cmu-argus-1/Avionics-JetsonCarrier/USB3-2.kicad_sch

## KiCad design USB3-2.kicad_sch (2024-07-25)

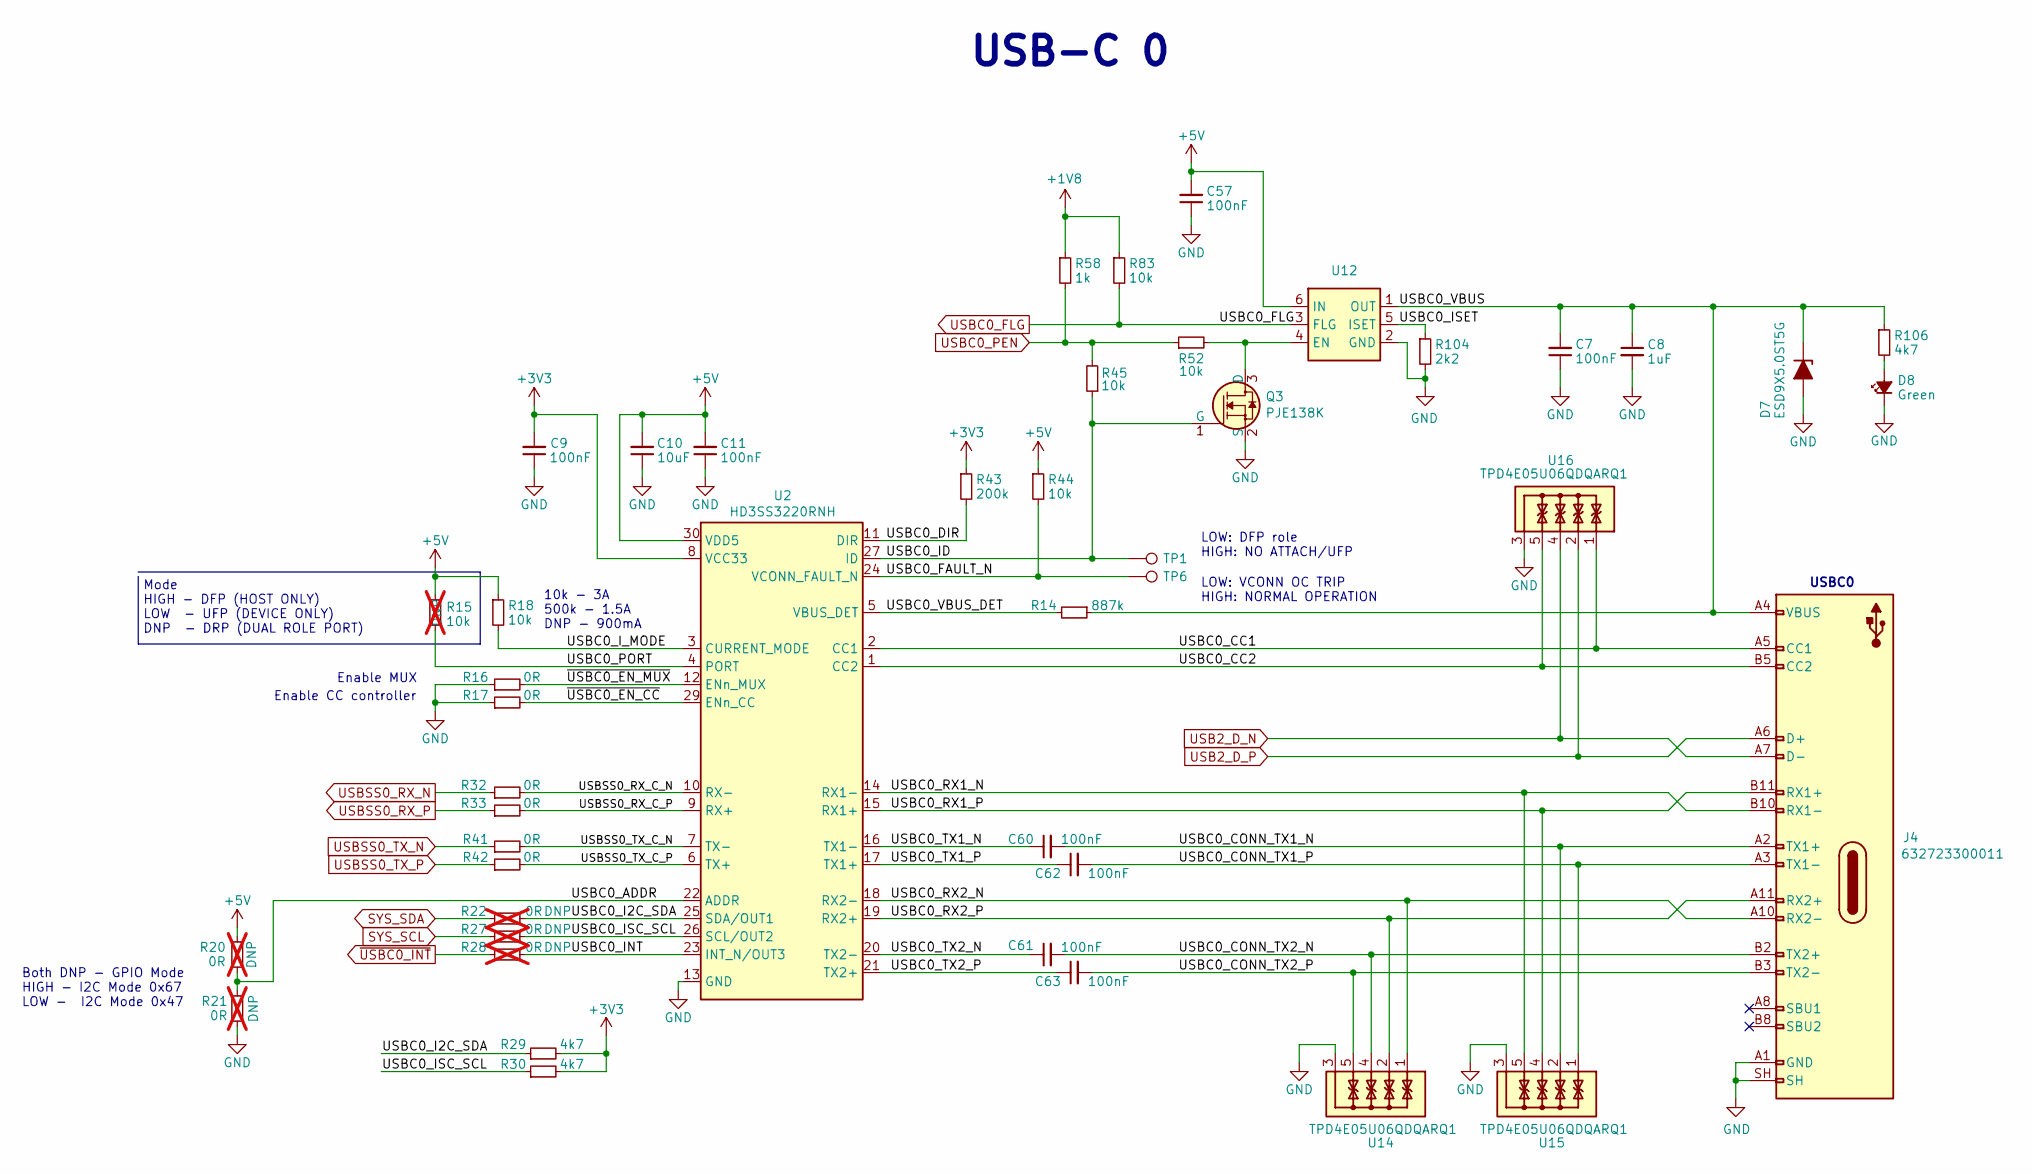
[picture p1: schematic USB3-2.kicad_sch]

Parts:
C7, C57: 100nF; C_0603_1608Metric; Voltage 50V; MPN GRM155R61H104KE14D
C8: 1uF; C_0603_1608Metric; MPN C0402C105M4PACTU
C9, C11, C60, C61, C62, C63: 100nF; C_0402_1005Metric; Voltage 50V; MPN GRM155R61H104KE14D
C10: 10uF; C_0402_1005Metric; MPN GRM188R61A106KE69D
D7: ESD9X5.0ST5G; D_SOD-923; MPN DF2S30FS
D8: LED_G_0603_LTST-C190GKT; LED_0603_1608Metric; MPN LTST-C190GKT
J4: 632723300011; USB-C_Receptacle_WE_632723300011; MPN 632723300011
Q3: PJE138K; SOT-523; MPN PJE138K_R1_00001
R14: 887k; R_0402_1005Metric; Tolerance 1%; MPN ERJ-2RKF8873X
R15: 10k; R_0402_1005Metric; Tolerance 1%; MPN CR0402-FX-1002GLF; not fitted
R16, R17, R32, R33, R41, R42: 0R; R_0402_1005Metric; MPN ERJ2GE0R00X
R18, R44, R45, R52, R83: 10k; R_0402_1005Metric; Tolerance 1%; MPN CR0402-FX-1002GLF
R20, R21, R22, R27, R28: 0R; R_0402_1005Metric; MPN ERJ2GE0R00X; not fitted
R29, R30: 4k7; R_0402_1005Metric; Tolerance 1%; MPN CR0402-FX-2003GLF
R43: 200k; R_0402_1005Metric; Tolerance 1%; MPN CR0402-FX-2003GLF
R58: 1k; R_0402_1005Metric; Tolerance 1%; MPN CR0402-FX-1002GLF
R104: 2k2; R_0402_1005Metric; Tolerance 1%; MPN CR0402-FX-2201GLF
R106: 4k7; R_0402_1005Metric; Tolerance 1%; MPN CR0402-FX-4701GLF
TP1, TP6: TP_0.75mm_SMD; TP_SMD_0.75mm
U2: HD3SS3220RNH; WQFN-30-1EP_4.6x2.6mm_P0.4mm; MPN HD3SS3220RNHT
U12: AP22615A_TSOT26; TSOT-23-6; MPN AP22615AWU-7
U14, U15, U16: TPD4E05U06QDQARQ1; USON-10_2.5x1mm_P0.5mm; MPN TPD4E05U06QDQARQ1

Connections:
+1V8: R58.1, R83.1
+3V3: C9.2, R29.2, R30.2, R43.1, U2.8 (VCC33)
+5V: C10.2, C11.2, C57.2, R15.2, R18.1, R20.2, R44.1, U2.30 (VDD5), U12.6 (IN)
GND: C7.1, C8.2, C9.1, C10.1, C11.1, C57.1, D7.2 (A), D8.1 (K), J4.A1 (GND), J4.A12 (GND), J4.B1 (GND), J4.B12 (GND), J4.SH, Q3.2 (S), R16.1, R17.1, R21.1, R104.2, U2.13 (GND), U2.28 (GND), U2.31 (GND), U12.2 (GND), U14.3, U14.8, U15.3, U15.8, U16.3, U16.8
unnamed: D8.2 (A), R106.2
unnamed: Q3.3 (D), R52.2, U12.4 (EN)
SYS_SCL: R27.1
SYS_SDA: R22.1
USB2_D_N: J4.A7 (D-), J4.B7 (D-), U16.4, U16.7
USB2_D_P: J4.A6 (D+), J4.B6 (D+), U16.2, U16.9
USBC0_ADDR: R20.1, R21.2, U2.22 (ADDR)
USBC0_CC1: J4.A5 (CC1), U2.2 (CC1), U16.1, U16.10
USBC0_CC2: J4.B5 (CC2), U2.1 (CC2), U16.5, U16.6
USBC0_CONN_TX1_N: C60.2, J4.A2 (TX1+), U15.2, U15.9
USBC0_CONN_TX1_P: C62.2, J4.A3 (TX1-), U15.1, U15.10
USBC0_CONN_TX2_N: C61.2, J4.B2 (TX2+), U14.4, U14.7
USBC0_CONN_TX2_P: C63.2, J4.B3 (TX2-), U14.5, U14.6
USBC0_DIR: R43.2, U2.11 (DIR)
USBC0_FAULT_N: R44.2, TP6.1, U2.24 (VCONN_FAULT_N)
USBC0_FLG: R83.2, U12.3 (FLG)
USBC0_I2C_SDA: R22.2, R29.1, U2.25 (SDA/OUT1)
USBC0_ID: Q3.1 (G), R45.1, TP1.1, U2.27 (ID)
USBC0_INT: R28.2, U2.23 (INT_N/OUT3)
USBC0_ISC_SCL: R27.2, R30.1, U2.26 (SCL/OUT2)
USBC0_ISET: R104.1, U12.5 (ISET)
USBC0_I_MODE: R18.2, U2.3 (CURRENT_MODE)
USBC0_PEN: R45.2, R52.1, R58.2
USBC0_PORT: R15.1, U2.4 (PORT)
USBC0_RX1_N: J4.B10 (RX1-), U2.14 (RX1-), U15.5, U15.6
USBC0_RX1_P: J4.B11 (RX1+), U2.15 (RX1+), U15.4, U15.7
USBC0_RX2_N: J4.A10 (RX2-), U2.18 (RX2-), U14.1, U14.10
USBC0_RX2_P: J4.A11 (RX2+), U2.19 (RX2+), U14.2, U14.9
USBC0_TX1_N: C60.1, U2.16 (TX1-)
USBC0_TX1_P: C62.1, U2.17 (TX1+)
USBC0_TX2_N: C61.1, U2.20 (TX2-)
USBC0_TX2_P: C63.1, U2.21 (TX2+)
USBC0_VBUS: C7.2, C8.1, D7.1 (K), J4.A4 (VBUS), J4.A9 (VBUS), J4.B4 (VBUS), J4.B9 (VBUS), R14.1, R106.1, U12.1 (OUT)
USBC0_VBUS_DET: R14.2, U2.5 (VBUS_DET)
USBSS0_RX_C_N: R32.2, U2.10 (RX-)
USBSS0_RX_C_P: R33.2, U2.9 (RX+)
USBSS0_RX_N: R32.1
USBSS0_RX_P: R33.1
USBSS0_TX_C_N: R41.2, U2.7 (TX-)
USBSS0_TX_C_P: R42.2, U2.6 (TX+)
USBSS0_TX_N: R41.1
USBSS0_TX_P: R42.1
~USBC0_EN_CC: R17.2, U2.29 (ENn_CC)
~USBC0_EN_MUX: R16.2, U2.12 (ENn_MUX)
~USBC0_INT: R28.1

Notes on the sheet:
USBC0
Enable CC controller
Mode HIGH - DFP (HOST ONLY) LOW - UFP (DEVICE ONLY) DNP - DRP (DUAL ROLE PORT)
Both DNP - GPIO Mode HIGH - I2C Mode 0x67 LOW - I2C Mode 0x47
USB-C 0
LOW: DFP role HIGH: NO ATTACH/UFP
LOW: VCONN OC TRIP HIGH: NORMAL OPERATION
10k - 3A 500k - 1.5A DNP - 900mA
Enable MUX
