cmu-argus-1/Avionics-JetsonCarrier/csi.kicad_sch

## KiCad design csi.kicad_sch (2024-07-25)

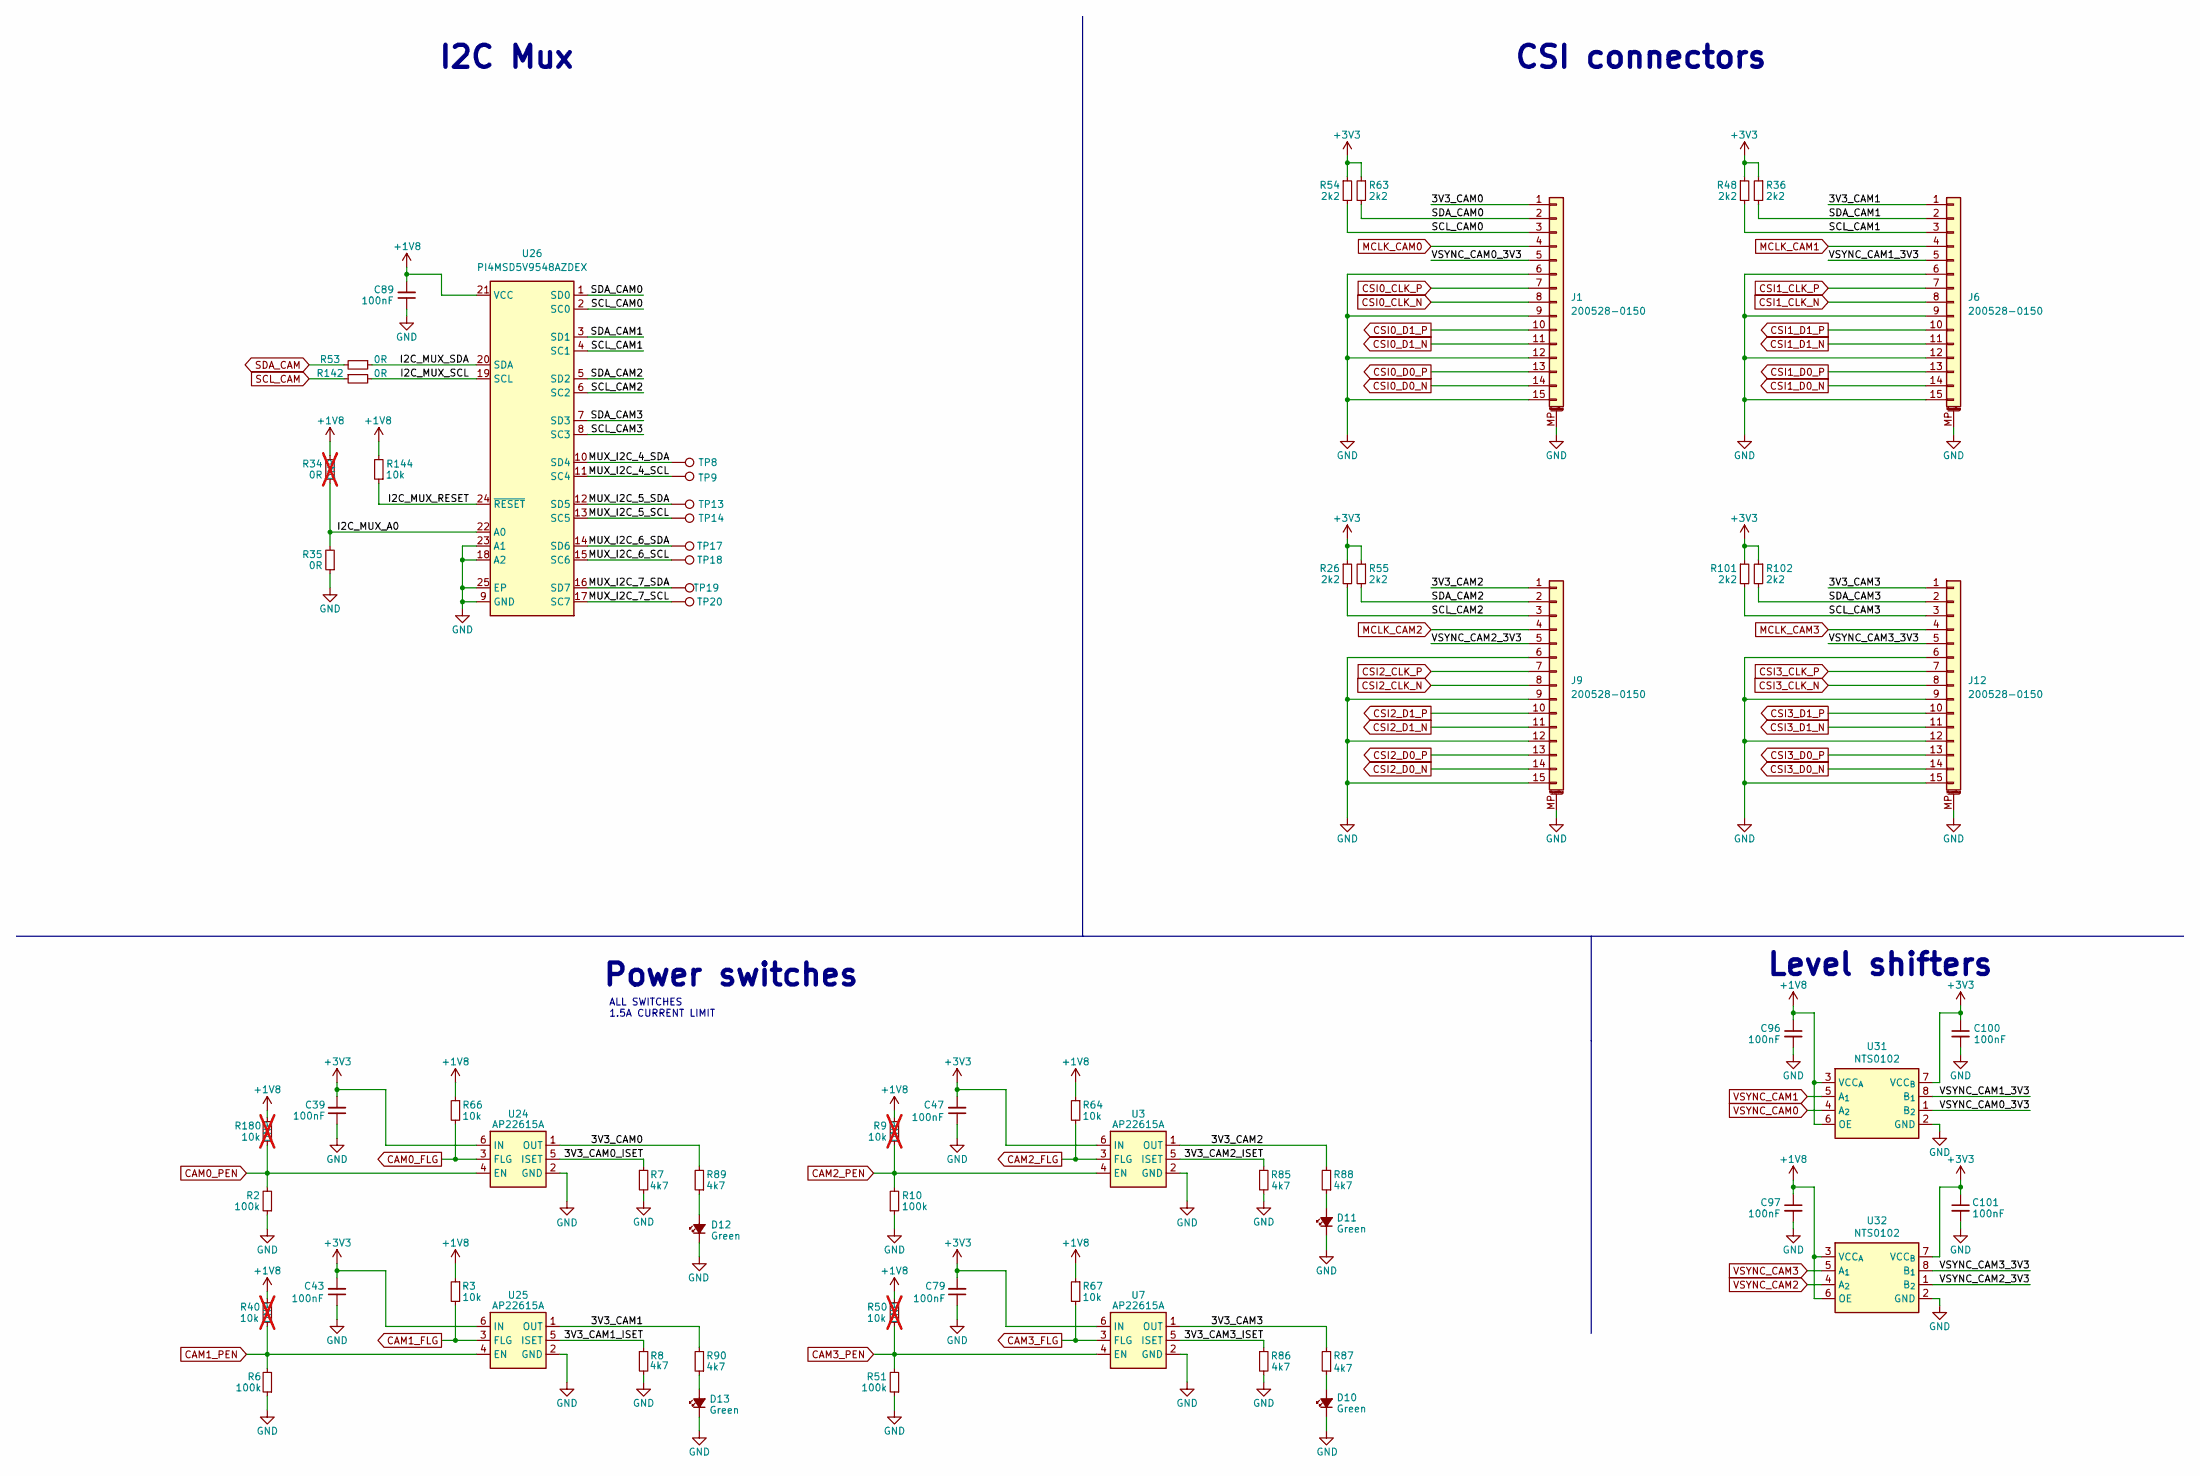
[picture p2: schematic csi.kicad_sch]

Parts:
C39, C43, C47, C79, C89, C96, C97, C100, C101: 100nF; C_0603_1608Metric; Voltage 50V; MPN GRM155R61H104KE14D
D10, D11, D12, D13: LED_G_0603_LTST-C190GKT; LED_0603_1608Metric; MPN LTST-C190GKT
J1, J6, J9, J12: 200528-0150; Molex_200528-0150_1x15-1MP_P1.00mm_Horizontal
R2, R6, R10, R51: 100k; R_0603_1608Metric; Tolerance 1%; MPN CR0402-FX-1003GLF
R3, R64, R66, R67, R144: 10k; R_0603_1608Metric; Tolerance 1%; MPN CR0402-FX-1002GLF
R7, R8, R85, R86, R87, R88, R89, R90: 4k7; R_0603_1608Metric; Tolerance 1%; MPN CR0402-FX-4701GLF
R9, R40, R50, R180: 10k; R_0603_1608Metric; Tolerance 1%; MPN CR0402-FX-1002GLF; not fitted
R26, R36, R48, R54, R55, R63, R101, R102: 2k2; R_0402_1005Metric
R34: 0R; R_0402_1005Metric; MPN ERJ2GE0R00X; not fitted
R35, R53, R142: 0R; R_0402_1005Metric; MPN ERJ2GE0R00X
TP8, TP9, TP13, TP14, TP17, TP18, TP19, TP20: TP_0.75mm_SMD; TP_SMD_0.75mm
U3, U7, U24, U25: AP22615A; TSOT-23-6; MPN AP22615AWU-7
U26: PI4MSD5V9548AZDEX; VQFN-24-1EP_3.8x3.8x1.0mm_P0.5mm; MPN PI4MSD5V9548AZDEX
U31, U32: NTS0102; XSON-8_1x1.95mm_P0.5mm; MPN NTS0102GT

Connections:
3V3_CAM0: J1.1, R89.2, U24.1 (OUT)
3V3_CAM0_ISET: R7.1, U24.5 (ISET)
3V3_CAM1: J6.1, R90.2, U25.1 (OUT)
3V3_CAM1_ISET: R8.1, U25.5 (ISET)
3V3_CAM2: J9.1, R88.2, U3.1 (OUT)
3V3_CAM2_ISET: R85.1, U3.5 (ISET)
3V3_CAM3: J12.1, R87.2, U7.1 (OUT)
3V3_CAM3_ISET: R86.1, U7.5 (ISET)
+1V8: C89.2, C96.1, C97.1, R3.1, R9.1, R34.2, R40.1, R50.1, R64.1, R66.1, R67.1, R144.2, R180.1, U26.21 (VCC), U31.3 (VCC_{A}), U31.6 (OE), U32.3 (VCC_{A}), U32.6 (OE)
+3V3: C39.2, C43.2, C47.2, C79.2, C100.1, C101.1, R26.1, R36.1, R48.1, R54.1, R55.1, R63.1, R101.1, R102.1, U3.6 (IN), U7.6 (IN), U24.6 (IN), U25.6 (IN), U31.7 (VCC_{B}), U32.7 (VCC_{B})
CAM0_FLG: R66.2, U24.3 (FLG)
CAM0_PEN: R2.2, R180.2, U24.4 (EN)
CAM1_FLG: R3.2, U25.3 (FLG)
CAM1_PEN: R6.2, R40.2, U25.4 (EN)
CAM2_FLG: R64.2, U3.3 (FLG)
CAM2_PEN: R9.2, R10.2, U3.4 (EN)
CAM3_FLG: R67.2, U7.3 (FLG)
CAM3_PEN: R50.2, R51.2, U7.4 (EN)
CSI0_CLK_N: J1.8
CSI0_CLK_P: J1.7
CSI0_D0_N: J1.14
CSI0_D0_P: J1.13
CSI0_D1_N: J1.11
CSI0_D1_P: J1.10
CSI1_CLK_N: J6.8
CSI1_CLK_P: J6.7
CSI1_D0_N: J6.14
CSI1_D0_P: J6.13
CSI1_D1_N: J6.11
CSI1_D1_P: J6.10
CSI2_CLK_N: J9.8
CSI2_CLK_P: J9.7
CSI2_D0_N: J9.14
CSI2_D0_P: J9.13
CSI2_D1_N: J9.11
CSI2_D1_P: J9.10
CSI3_CLK_N: J12.8
CSI3_CLK_P: J12.7
CSI3_D0_N: J12.14
CSI3_D0_P: J12.13
CSI3_D1_N: J12.11
CSI3_D1_P: J12.10
GND: C39.1, C43.1, C47.1, C79.1, C89.1, C96.2, C97.2, C100.2, C101.2, D10.1 (K), D11.1 (K), D12.1 (K), D13.1 (K), J1.6, J1.9, J1.12, J1.15, J1.MP (MountPin), J6.6, J6.9, J6.12, J6.15, J6.MP (MountPin), J9.6, J9.9, J9.12, J9.15, J9.MP (MountPin), J12.6, J12.9, J12.12, J12.15, J12.MP (MountPin), R2.1, R6.1, R7.2, R8.2, R10.1, R35.1, R51.1, R85.2, R86.2, U3.2 (GND), U7.2 (GND), U24.2 (GND), U25.2 (GND), U26.9 (GND), U26.18 (A2), U26.23 (A1), U26.25 (EP), U31.2 (GND), U32.2 (GND)
I2C_MUX_A0: R34.1, R35.2, U26.22 (A0)
I2C_MUX_RESET: R144.1, U26.24 (~RESET)
I2C_MUX_SCL: R142.2, U26.19 (SCL)
I2C_MUX_SDA: R53.1, U26.20 (SDA)
MCLK_CAM0: J1.4
MCLK_CAM1: J6.4
MCLK_CAM2: J9.4
MCLK_CAM3: J12.4
MUX_I2C_4_SCL: TP9.1, U26.11 (SC4)
MUX_I2C_4_SDA: TP8.1, U26.10 (SD4)
MUX_I2C_5_SCL: TP14.1, U26.13 (SC5)
MUX_I2C_5_SDA: TP13.1, U26.12 (SD5)
MUX_I2C_6_SCL: TP18.1, U26.15 (SC6)
MUX_I2C_6_SDA: TP17.1, U26.14 (SD6)
MUX_I2C_7_SCL: TP20.1, U26.17 (SC7)
MUX_I2C_7_SDA: TP19.1, U26.16 (SD7)
unnamed: D10.2 (A), R87.1
unnamed: D11.2 (A), R88.1
unnamed: D12.2 (A), R89.1
unnamed: D13.2 (A), R90.1
SCL_CAM: R142.1
SCL_CAM0: J1.3, R54.2, U26.2 (SC0)
SCL_CAM1: J6.3, R48.2, U26.4 (SC1)
SCL_CAM2: J9.3, R26.2, U26.6 (SC2)
SCL_CAM3: J12.3, R101.2, U26.8 (SC3)
SDA_CAM: R53.2
SDA_CAM0: J1.2, R63.2, U26.1 (SD0)
SDA_CAM1: J6.2, R36.2, U26.3 (SD1)
SDA_CAM2: J9.2, R55.2, U26.5 (SD2)
SDA_CAM3: J12.2, R102.2, U26.7 (SD3)
VSYNC_CAM0: U31.4 (A_{2})
VSYNC_CAM0_3V3: J1.5, U31.1 (B_{2})
VSYNC_CAM1: U31.5 (A_{1})
VSYNC_CAM1_3V3: J6.5, U31.8 (B_{1})
VSYNC_CAM2: U32.4 (A_{2})
VSYNC_CAM2_3V3: J9.5, U32.1 (B_{2})
VSYNC_CAM3: U32.5 (A_{1})
VSYNC_CAM3_3V3: J12.5, U32.8 (B_{1})

Notes on the sheet:
Power switches
CSI connectors
I2C Mux
ALL SWITCHES 1.5A CURRENT LIMIT
Level shifters
