cmu-argus-1/Avionics-JetsonCarrier/hdmi.kicad_sch

## KiCad design hdmi.kicad_sch (2024-07-25)

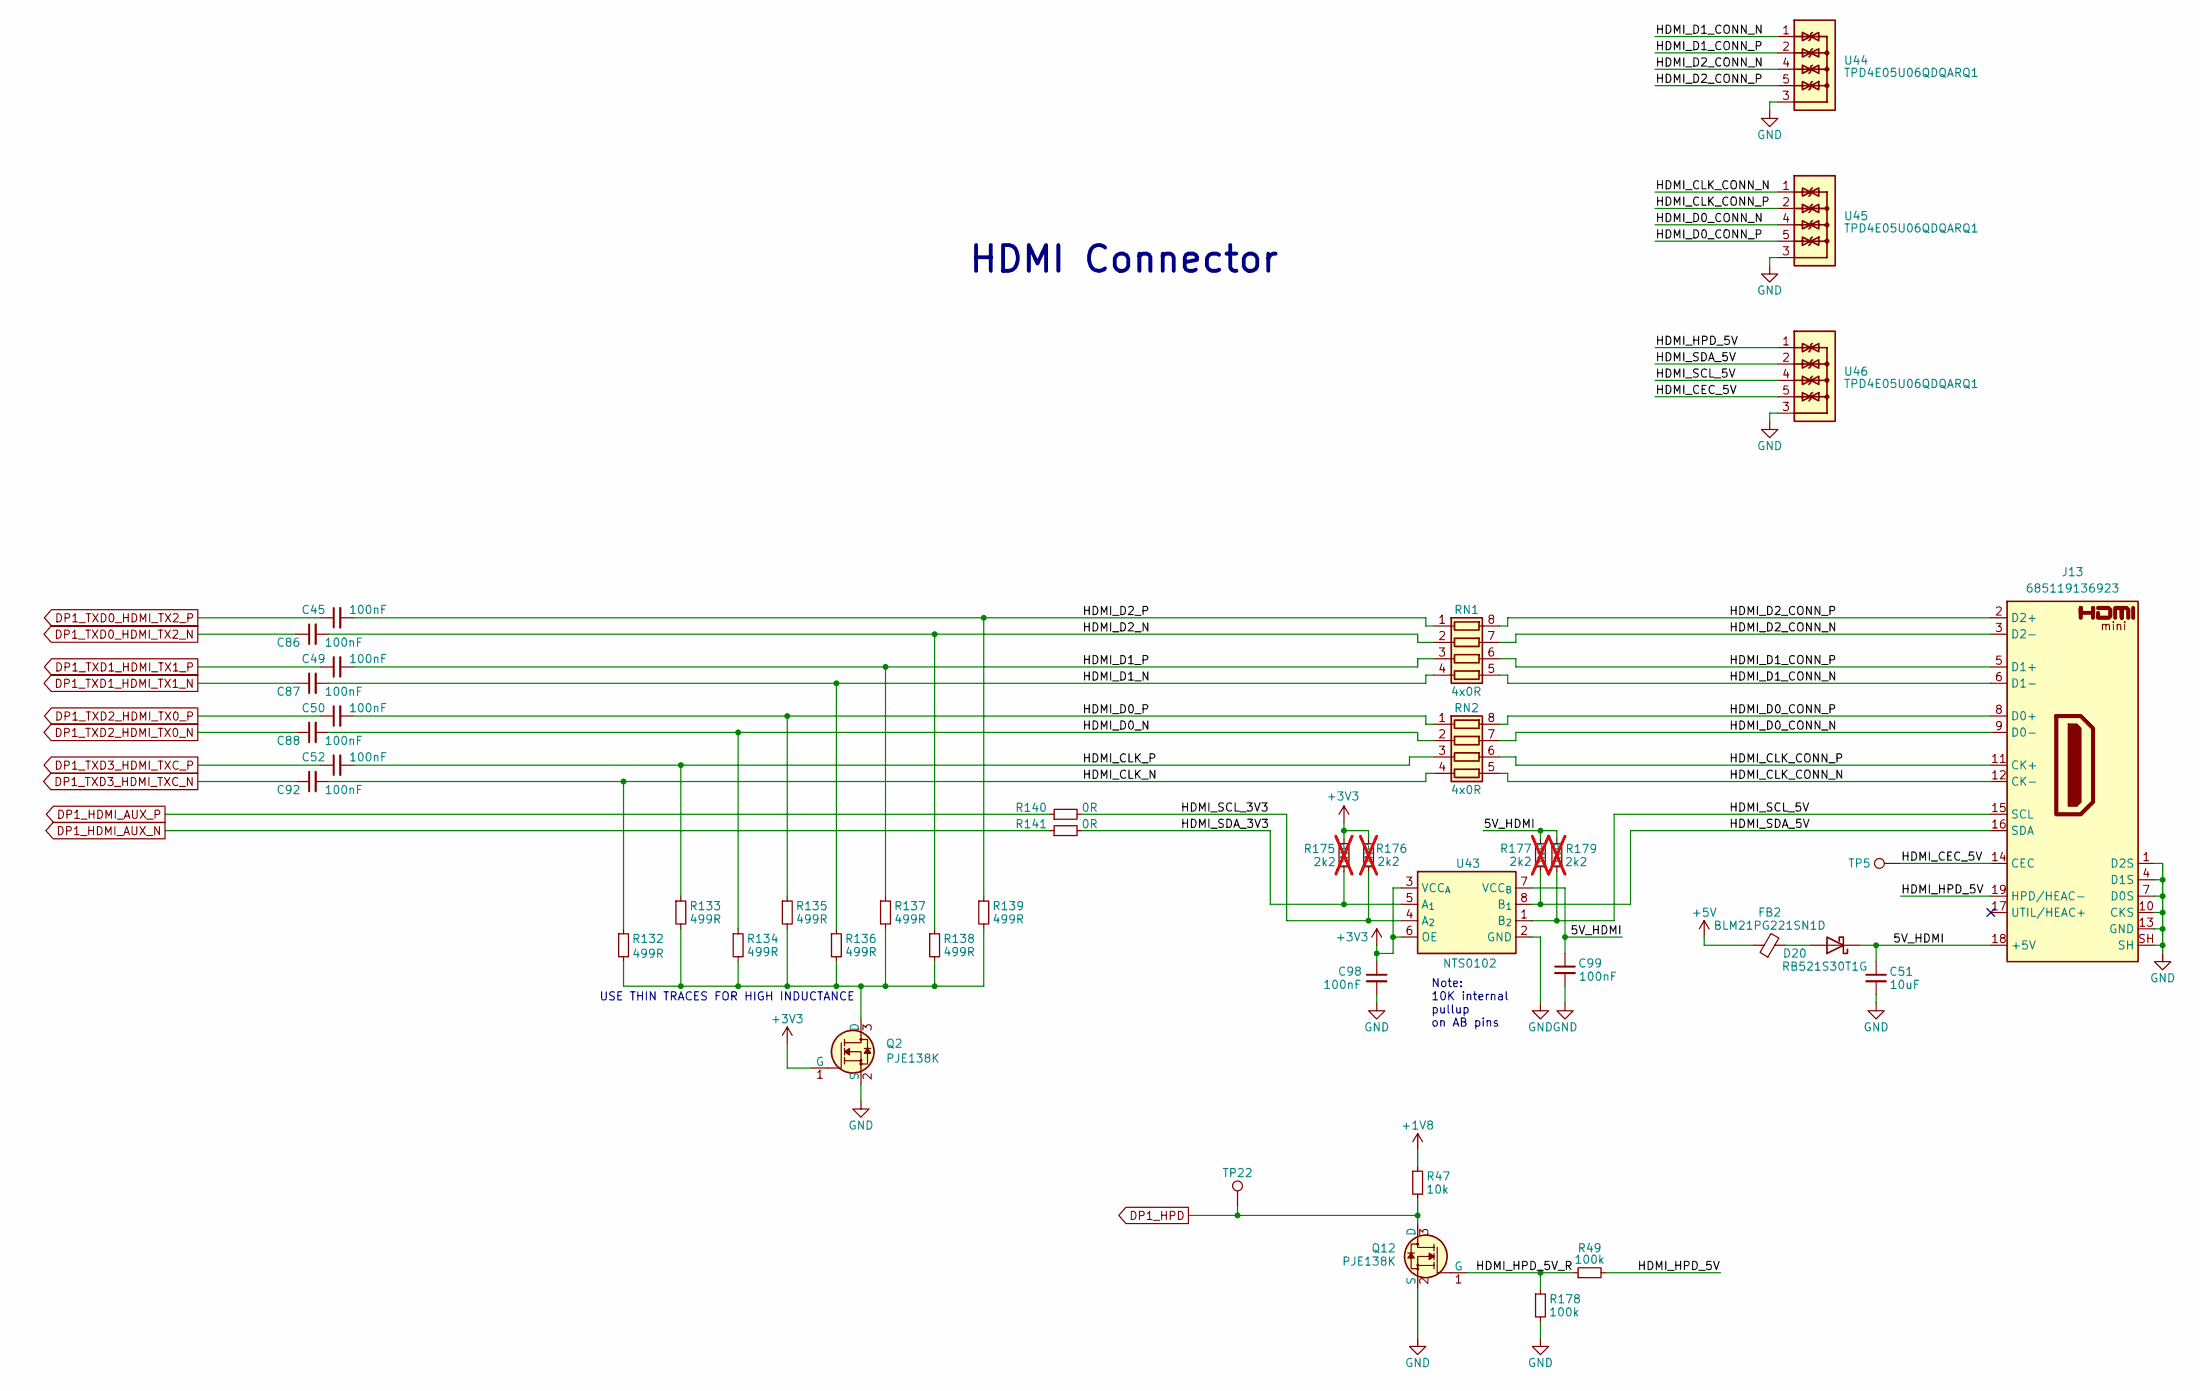
[picture p3: schematic hdmi.kicad_sch]

Parts:
C45, C49, C50, C52, C86, C87, C88, C92: 100nF; C_0402_1005Metric; Voltage 50V; MPN GRM155R61H104KE14D
C51: 10uF; C_0603_1608Metric; MPN GRM188R61A106KE69D
C98, C99: 100nF; C_0603_1608Metric; Voltage 50V; MPN GRM155R61H104KE14D
D20: RB521S30T1G; D_SOD-523; MPN RB521S30T1G
FB2: BLM21PG221SN1D; L_0603_1608Metric; MPN BLM21PG221SN1D
J13: 685119136923; HDMI-Mini-C_Receptacle_WE_685119136923; MPN 685119136923
Q2, Q12: PJE138K; SOT-523; MPN PJE138K_R1_00001
R47: 10k; R_0603_1608Metric; Tolerance 1%; MPN CR0402-FX-1002GLF
R49, R178: 100k; R_0603_1608Metric; Tolerance 1%; MPN CR0402-FX-2201GLF
R132, R133, R134, R135, R136, R137, R138, R139: 499R; R_0402_1005Metric; Tolerance 1%; MPN CR0402-FX-4990GLF
R140, R141: 0R; R_0402_1005Metric; MPN ERJ2GE0R00X
R175, R176, R177, R179: 2k2; R_0402_1005Metric; Tolerance 1%; MPN CR0402-FX-2201GLF; not fitted
RN1, RN2: 4x0R; R_Array_Concave_4x0402; MPN EXB-18VR000X
TP5, TP22: TP_0.75mm_SMD; TP_SMD_0.75mm
U43: NTS0102; XSON-8_1x1.95mm_P0.5mm; MPN NTS0102GT
U44, U45, U46: TPD4E05U06QDQARQ1; USON-10_2.5x1mm_P0.5mm; MPN TPD4E05U06QDQARQ1

Connections:
5V_HDMI: C51.1, C99.1, D20.1 (K), J13.18 (+5V), R177.2, R179.1, U43.7 (VCC_{B})
+1V8: R47.1
+3V3: C98.1, Q2.1 (G), R175.1, R176.2, U43.3 (VCC_{A}), U43.6 (OE)
+5V: FB2.1
DP1_HDMI_AUX_N: R141.1
DP1_HDMI_AUX_P: R140.1
DP1_HPD: Q12.3 (D), R47.2, TP22.1
DP1_TXD0_HDMI_TX2_N: C86.1
DP1_TXD0_HDMI_TX2_P: C45.1
DP1_TXD1_HDMI_TX1_N: C87.1
DP1_TXD1_HDMI_TX1_P: C49.1
DP1_TXD2_HDMI_TX0_N: C88.1
DP1_TXD2_HDMI_TX0_P: C50.1
DP1_TXD3_HDMI_TXC_N: C92.1
DP1_TXD3_HDMI_TXC_P: C52.1
GND: C51.2, C98.2, C99.2, J13.1 (D2S), J13.4 (D1S), J13.7 (D0S), J13.10 (CKS), J13.13 (GND), J13.SH, Q2.2 (S), Q12.2 (S), R178.2, U43.2 (GND), U44.3, U44.8, U45.3, U45.8, U46.3, U46.8
HDMI_CEC_5V: J13.14 (CEC), TP5.1, U46.5, U46.6
HDMI_CLK_CONN_N: J13.12 (CK-), RN2.5 (R4.2), U45.1, U45.10
HDMI_CLK_CONN_P: J13.11 (CK+), RN2.6 (R3.2), U45.2, U45.9
HDMI_CLK_N: C92.2, R132.1, RN2.4 (R4.1)
HDMI_CLK_P: C52.2, R133.1, RN2.3 (R3.1)
HDMI_D0_CONN_N: J13.9 (D0-), RN2.7 (R2.2), U45.4, U45.7
HDMI_D0_CONN_P: J13.8 (D0+), RN2.8 (R1.2), U45.5, U45.6
HDMI_D0_N: C88.2, R134.1, RN2.2 (R2.1)
HDMI_D0_P: C50.2, R135.1, RN2.1 (R1.1)
HDMI_D1_CONN_N: J13.6 (D1-), RN1.5 (R4.2), U44.1, U44.10
HDMI_D1_CONN_P: J13.5 (D1+), RN1.6 (R3.2), U44.2, U44.9
HDMI_D1_N: C87.2, R136.1, RN1.4 (R4.1)
HDMI_D1_P: C49.2, R137.1, RN1.3 (R3.1)
HDMI_D2_CONN_N: J13.3 (D2-), RN1.7 (R2.2), U44.4, U44.7
HDMI_D2_CONN_P: J13.2 (D2+), RN1.8 (R1.2), U44.5, U44.6
HDMI_D2_N: C86.2, R138.1, RN1.2 (R2.1)
HDMI_D2_P: C45.2, R139.1, RN1.1 (R1.1)
HDMI_HPD_5V: J13.19 (HPD/HEAC-), R49.2, U46.1, U46.10
HDMI_HPD_5V_R: Q12.1 (G), R49.1, R178.1
HDMI_SCL_3V3: R140.2, R176.1, U43.4 (A_{2})
HDMI_SCL_5V: J13.15 (SCL), R179.2, U43.1 (B_{2}), U46.4, U46.7
HDMI_SDA_3V3: R141.2, R175.2, U43.5 (A_{1})
HDMI_SDA_5V: J13.16 (SDA), R177.1, U43.8 (B_{1}), U46.2, U46.9
unnamed: D20.2 (A), FB2.2
unnamed: Q2.3 (D), R132.2, R133.2, R134.2, R135.2, R136.2, R137.2, R138.2, R139.2

Notes on the sheet:
USE THIN TRACES FOR HIGH INDUCTANCE
Note: 10K internal pullup on AB pins
HDMI Connector
