cmu-argus-1/Avionics-JetsonCarrier/jetson-orin-baseboard.kicad_sch

## KiCad design jetson-orin-baseboard.kicad_sch (2024-07-25)

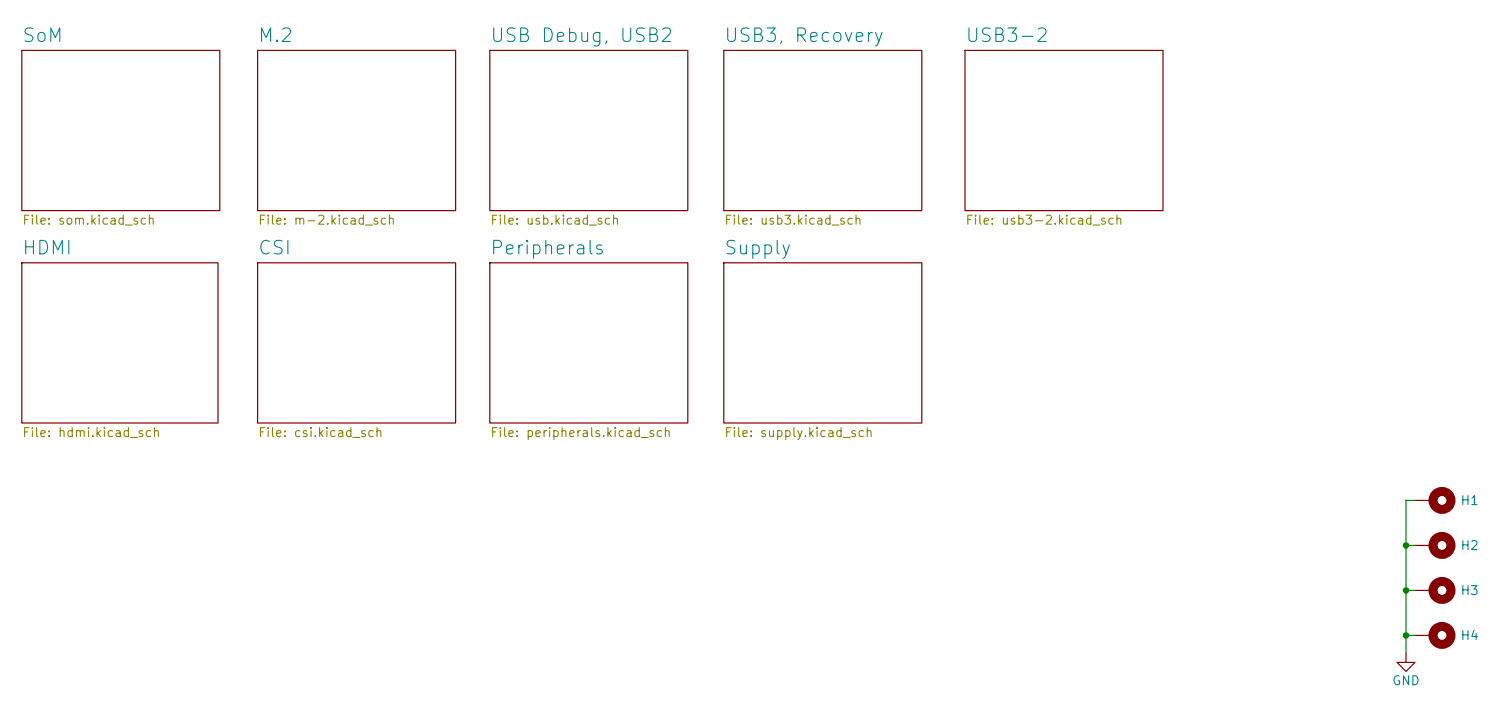
[picture p4: schematic jetson-orin-baseboard.kicad_sch]

Parts:
H1, H2, H3, H4: MountingHole_Pad; MountingHole2; MPN 9774065151R

Connections:
GND: H1.1, H2.1, H3.1, H4.1
