cmu-argus-1/Avionics-JetsonCarrier/m-2.kicad_sch

## KiCad design m-2.kicad_sch (2024-07-27)

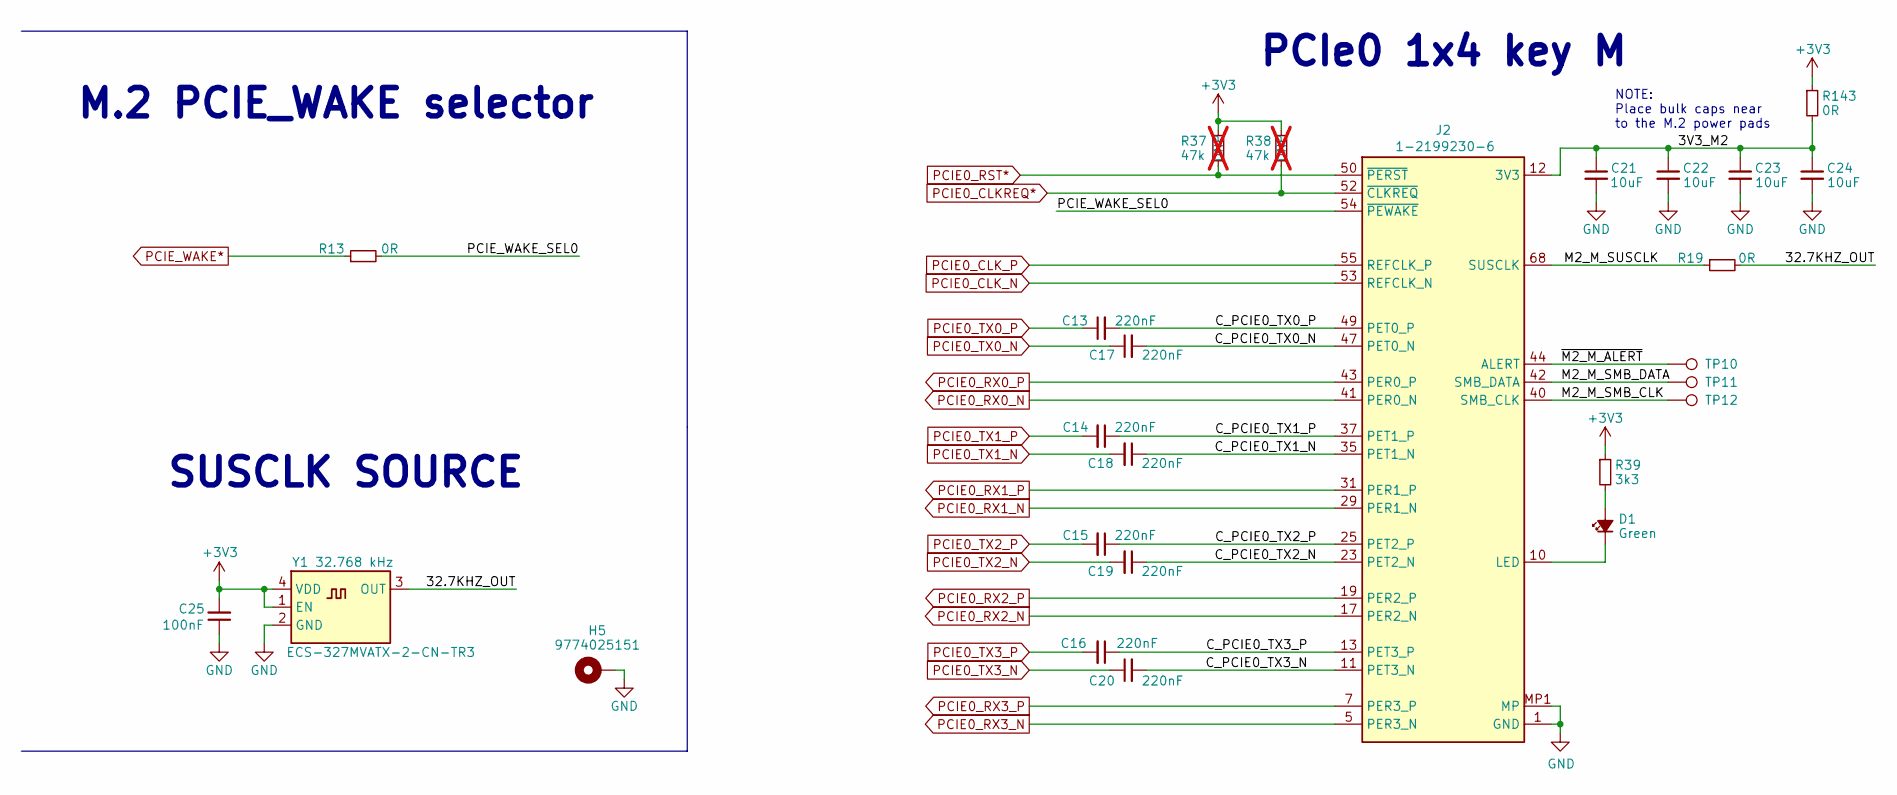
[picture p5: schematic m-2.kicad_sch]

Parts:
C13, C14, C15, C16, C17, C18, C19, C20: 220nF; C_0402_1005Metric; MPN CC0402KRX5R6BB224
C21, C22, C23, C24: 10uF; C_0603_1608Metric; MPN GRM188R61A106KE69D
C25: 100nF; C_0603_1608Metric; Voltage 50V; MPN GRM155R61H104KE14D
D1: LED_G_0603_LTST-C190GKT; LED_0603_1608Metric; MPN LTST-C190GKT
H5: 9774025151; Spacer_Drill3.7mm_H2.5mm_9774025151R; MPN 9774025151R
J2: 1-2199230-6; Bus_M.2_Socket_Key_M_TE_1-2199230-6; MPN 1-2199230-6
R13, R19: 0R; R_0402_1005Metric; MPN ERJ2GE0R00X
R37, R38: 47k; R_0402_1005Metric; Tolerance 1%; MPN CR0402-FX-4702GLF; not fitted
R39: 3k3; R_0603_1608Metric; Tolerance 1%
R143: 0R; R_0603_1608Metric; MPN PMR03EZPJ000
TP10, TP11, TP12: TP_0.75mm_SMD; TP_SMD_0.75mm
Y1: ECS-327MVATX-2-CN-TR3; Oscillator_SMD_ECS_2520MV_2.5x2mm; MPN ECS-327MVATX-2-CN-TR3

Connections:
3V3_M2: C21.1, C22.1, C23.1, C24.1, J2.2 (3V3), J2.4 (3V3), J2.12 (3V3), J2.14 (3V3), J2.16 (3V3), J2.18 (3V3), J2.70 (3V3), J2.72 (3V3), J2.74 (3V3), R143.2
32.7KHZ_OUT: R19.2, Y1.3 (OUT)
+3V3: C25.2, R37.1, R38.1, R39.1, R143.1, Y1.1 (EN), Y1.4 (VDD)
C_PCIE0_TX0_N: C17.2, J2.47 (PET0_N)
C_PCIE0_TX0_P: C13.2, J2.49 (PET0_P)
C_PCIE0_TX1_N: C18.1, J2.35 (PET1_N)
C_PCIE0_TX1_P: C14.1, J2.37 (PET1_P)
C_PCIE0_TX2_N: C19.1, J2.23 (PET2_N)
C_PCIE0_TX2_P: C15.1, J2.25 (PET2_P)
C_PCIE0_TX3_N: C20.2, J2.11 (PET3_N)
C_PCIE0_TX3_P: C16.1, J2.13 (PET3_P)
GND: C21.2, C22.2, C23.2, C24.2, C25.1, H5.1, J2.1 (GND), J2.3 (GND), J2.9 (GND), J2.15 (GND), J2.21 (GND), J2.27 (GND), J2.33 (GND), J2.39 (GND), J2.45 (GND), J2.51 (GND), J2.57 (GND), J2.71 (GND), J2.73 (GND), J2.75 (GND), J2.MP1 (MP), J2.MP2 (MP), Y1.2 (GND)
M2_M_SMB_CLK: J2.40 (SMB_CLK), TP12.1
M2_M_SMB_DATA: J2.42 (SMB_DATA), TP11.1
M2_M_SUSCLK: J2.68 (SUSCLK), R19.1
unnamed: D1.1 (K), J2.10 (LED)
unnamed: D1.2 (A), R39.2
PCIE0_CLKREQ*: J2.52 (~CLKREQ), R38.2
PCIE0_CLK_N: J2.53 (REFCLK_N)
PCIE0_CLK_P: J2.55 (REFCLK_P)
PCIE0_RST*: J2.50 (~PERST), R37.2
PCIE0_RX0_N: J2.41 (PER0_N)
PCIE0_RX0_P: J2.43 (PER0_P)
PCIE0_RX1_N: J2.29 (PER1_N)
PCIE0_RX1_P: J2.31 (PER1_P)
PCIE0_RX2_N: J2.17 (PER2_N)
PCIE0_RX2_P: J2.19 (PER2_P)
PCIE0_RX3_N: J2.5 (PER3_N)
PCIE0_RX3_P: J2.7 (PER3_P)
PCIE0_TX0_N: C17.1
PCIE0_TX0_P: C13.1
PCIE0_TX1_N: C18.2
PCIE0_TX1_P: C14.2
PCIE0_TX2_N: C19.2
PCIE0_TX2_P: C15.2
PCIE0_TX3_N: C20.1
PCIE0_TX3_P: C16.2
PCIE_WAKE*: R13.1
PCIE_WAKE_SEL0: J2.54 (~PEWAKE), R13.2
~M2_M_ALERT: J2.44 (ALERT), TP10.1

Notes on the sheet:
M.2 PCIE_WAKE selector
PCIe0 1x4 key M
NOTE: Place bulk caps near to the M.2 power pads
SUSCLK SOURCE
