cmu-argus-1/Avionics-JetsonCarrier/peripherals.kicad_sch

## KiCad design peripherals.kicad_sch (2024-07-25)

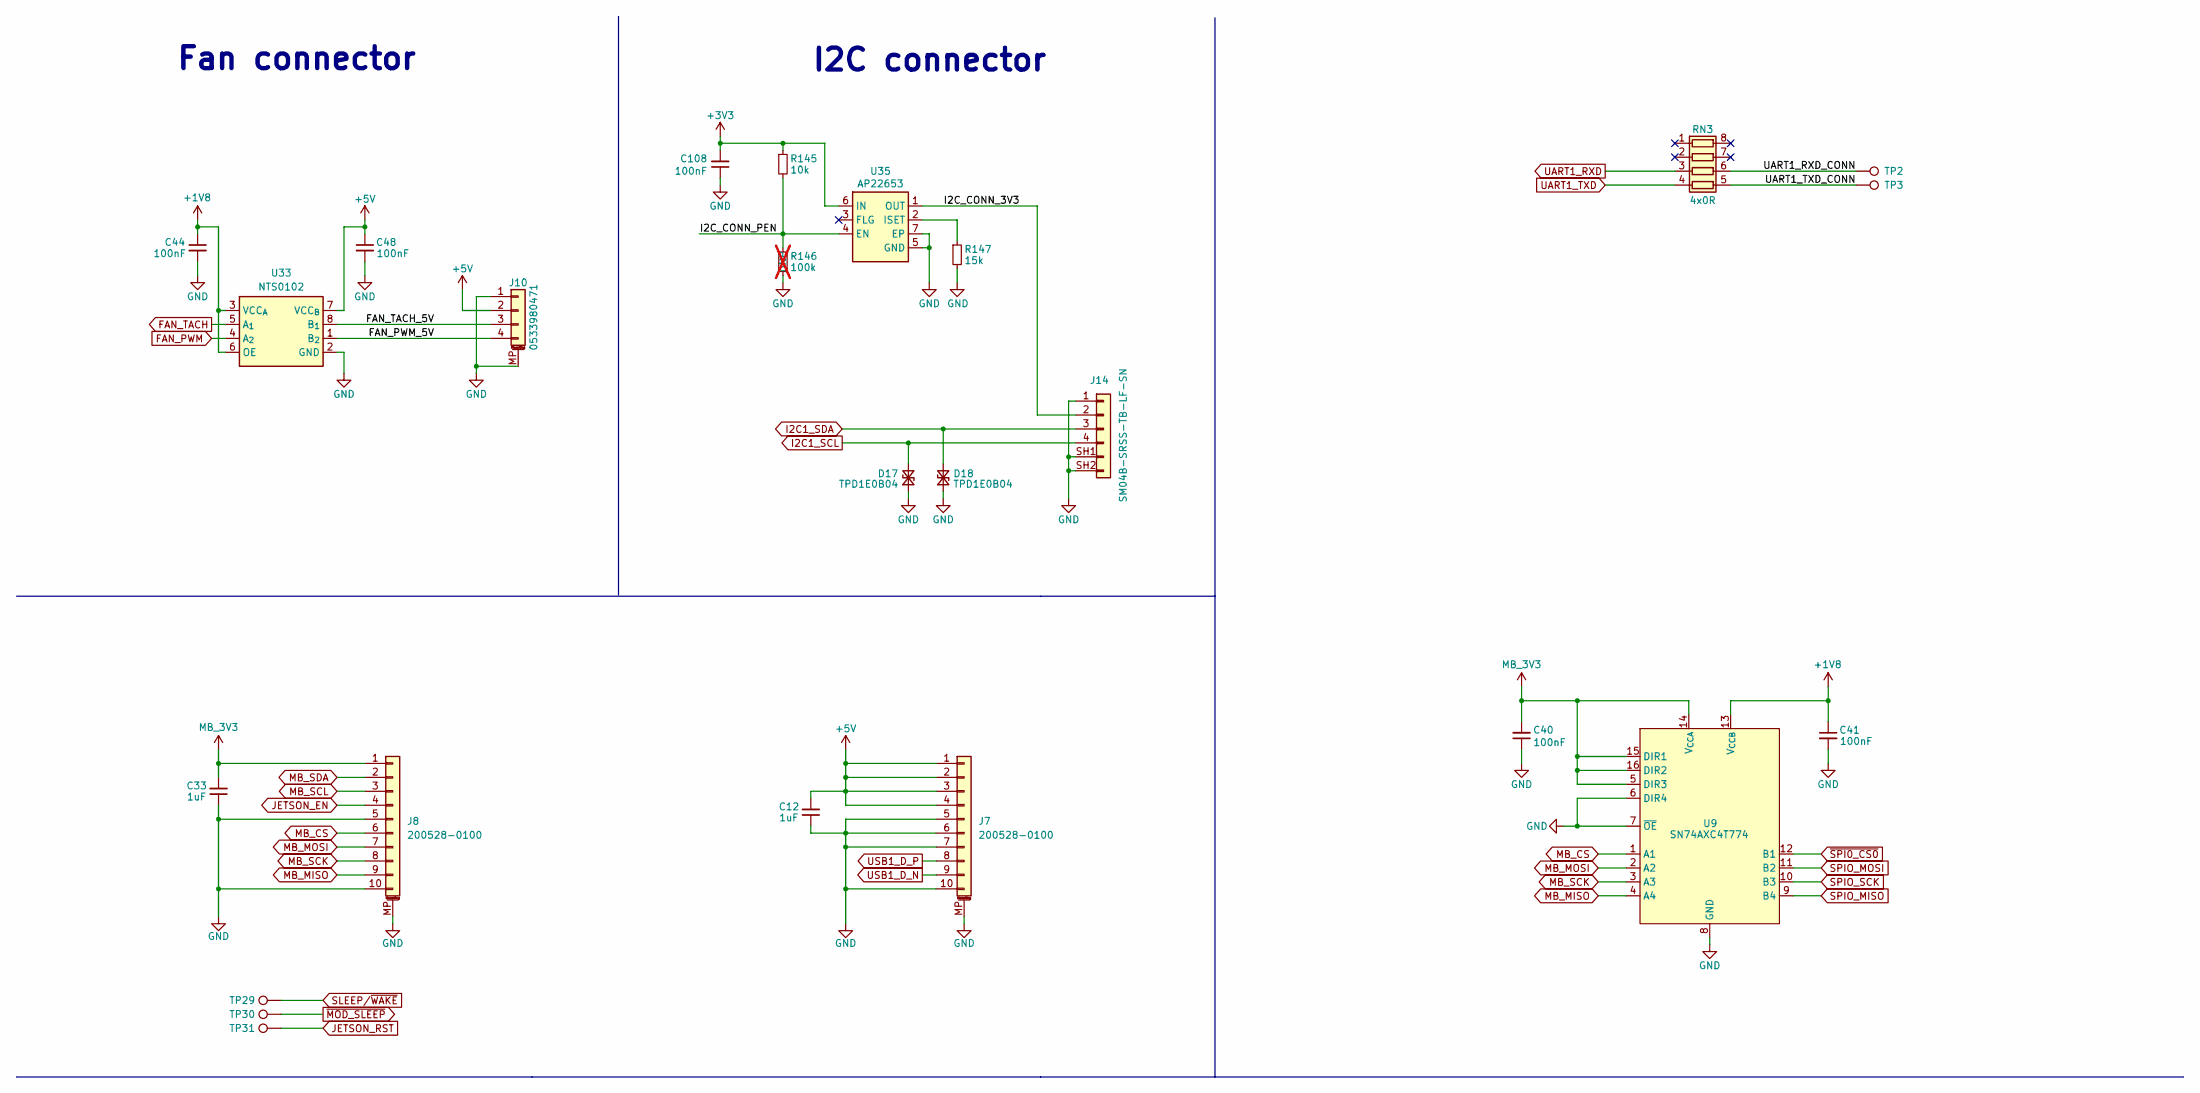
[picture p6: schematic peripherals.kicad_sch]

Parts:
C12, C33: 1uF; C_0603_1608Metric; MPN C1005X6S1A105K050BC
C40, C41: 100nF; C_0603_1608Metric; MPN C1005X6S1A105K050BC
C44, C48, C108: 100nF; C_0603_1608Metric; Voltage 50V; MPN GRM155R61H104KE14D
D17, D18: TPD1E0B04; D_SOD-882; MPN TPD1E0B04DPYR
J7, J8: 200528-0100; Molex_200528-0100_1x10-1MP_P1.00mm_Horizontal
J10: 0533980471; Molex_PicoBlade_53398-0471_1x04-1MP_P1.25mm_Vertical; MPN 0533980471
J14: SM04B-SRSS-TB-LF-SN; Conn_JST_SH_1x4_SM04B-SRSS-TB-LF-SN; MPN SM04B-SRSS-TB(LF)(SN)
R145: 10k; R_0603_1608Metric; Tolerance 1%; MPN CR0402-FX-1002GLF
R146: 100k; R_0603_1608Metric; Tolerance 1%; MPN CR0402-FX-1003GLF; not fitted
R147: 15k; R_0603_1608Metric; Tolerance 1%; MPN CR0402-FX-1502GLF
RN3: 4x0R; R_Array_Concave_4x0402; MPN EXB-28V331JX
TP2, TP3, TP29, TP30, TP31: TP_0.75mm_SMD; TP_SMD_0.75mm
U9: SN74AXC4T774; UQFN-16_1.8x2.6mm_P0.4mm
U33: NTS0102; XSON-8_1x1.95mm_P0.5mm; MPN NTS0102GT
U35: AP22653; DFN-6-1EP_2x2mm_P0.65mm_EP1x1.6mm; MPN AP22653FDZ-7

Connections:
+1V8: C41.1, C44.1, U9.13 (V_{CCB}), U33.3 (VCC_{A}), U33.6 (OE)
+3V3: C108.2, R145.1, U35.6 (IN)
+5V: C12.2, C48.1, J7.1, J7.2, J7.3, J7.4, J10.2, U33.7 (VCC_{B})
FAN_PWM: U33.4 (A_{2})
FAN_PWM_5V: J10.4, U33.1 (B_{2})
FAN_TACH: U33.5 (A_{1})
FAN_TACH_5V: J10.3, U33.8 (B_{1})
GND: C12.1, C33.1, C40.1, C41.2, C44.2, C48.2, C108.1, D17.1 (A1), D18.1 (A1), J7.5, J7.6, J7.7, J7.10, J7.MP (MountPin), J8.5, J8.10, J8.MP (MountPin), J10.1, J10.MP (MountPin), J14.1, J14.SH1, J14.SH2, R146.2, R147.2, U9.6 (DIR4), U9.7 (~OE), U9.8 (GND), U33.2 (GND), U35.5 (GND), U35.7 (EP)
I2C1_SCL: D17.2 (A2), J14.4
I2C1_SDA: D18.2 (A2), J14.3
I2C_CONN_3V3: J14.2, U35.1 (OUT)
I2C_CONN_PEN: R145.2, R146.1, U35.4 (EN)
JETSON_EN: J8.4
JETSON_RST: TP31.1
MB_3V3: C33.2, C40.2, J8.1, U9.5 (DIR3), U9.14 (V_{CCA}), U9.15 (DIR1), U9.16 (DIR2)
MB_CS: J8.6, U9.1 (A1)
MB_MISO: J8.9, U9.4 (A4)
MB_MOSI: J8.7, U9.2 (A2)
MB_SCK: J8.8, U9.3 (A3)
MB_SCL: J8.3
MB_SDA: J8.2
unnamed: R147.1, U35.2 (ISET)
SLEEP/~WAKE: TP29.1
SPIO_MISO: U9.9 (B4)
SPIO_MOSI: U9.11 (B2)
SPIO_SCK: U9.10 (B3)
UART1_RXD: RN3.3 (R3.1)
UART1_RXD_CONN: RN3.6 (R3.2), TP2.1
UART1_TXD: RN3.4 (R4.1)
UART1_TXD_CONN: RN3.5 (R4.2), TP3.1
USB1_D_N: J7.9
USB1_D_P: J7.8
~MOD_SLEEP: TP30.1
~SPI0_CS0: U9.12 (B1)

Notes on the sheet:
Fan connector
I2C connector
