cmu-argus-1/Avionics-JetsonCarrier/som.kicad_sch

## KiCad design som.kicad_sch (2024-07-25)

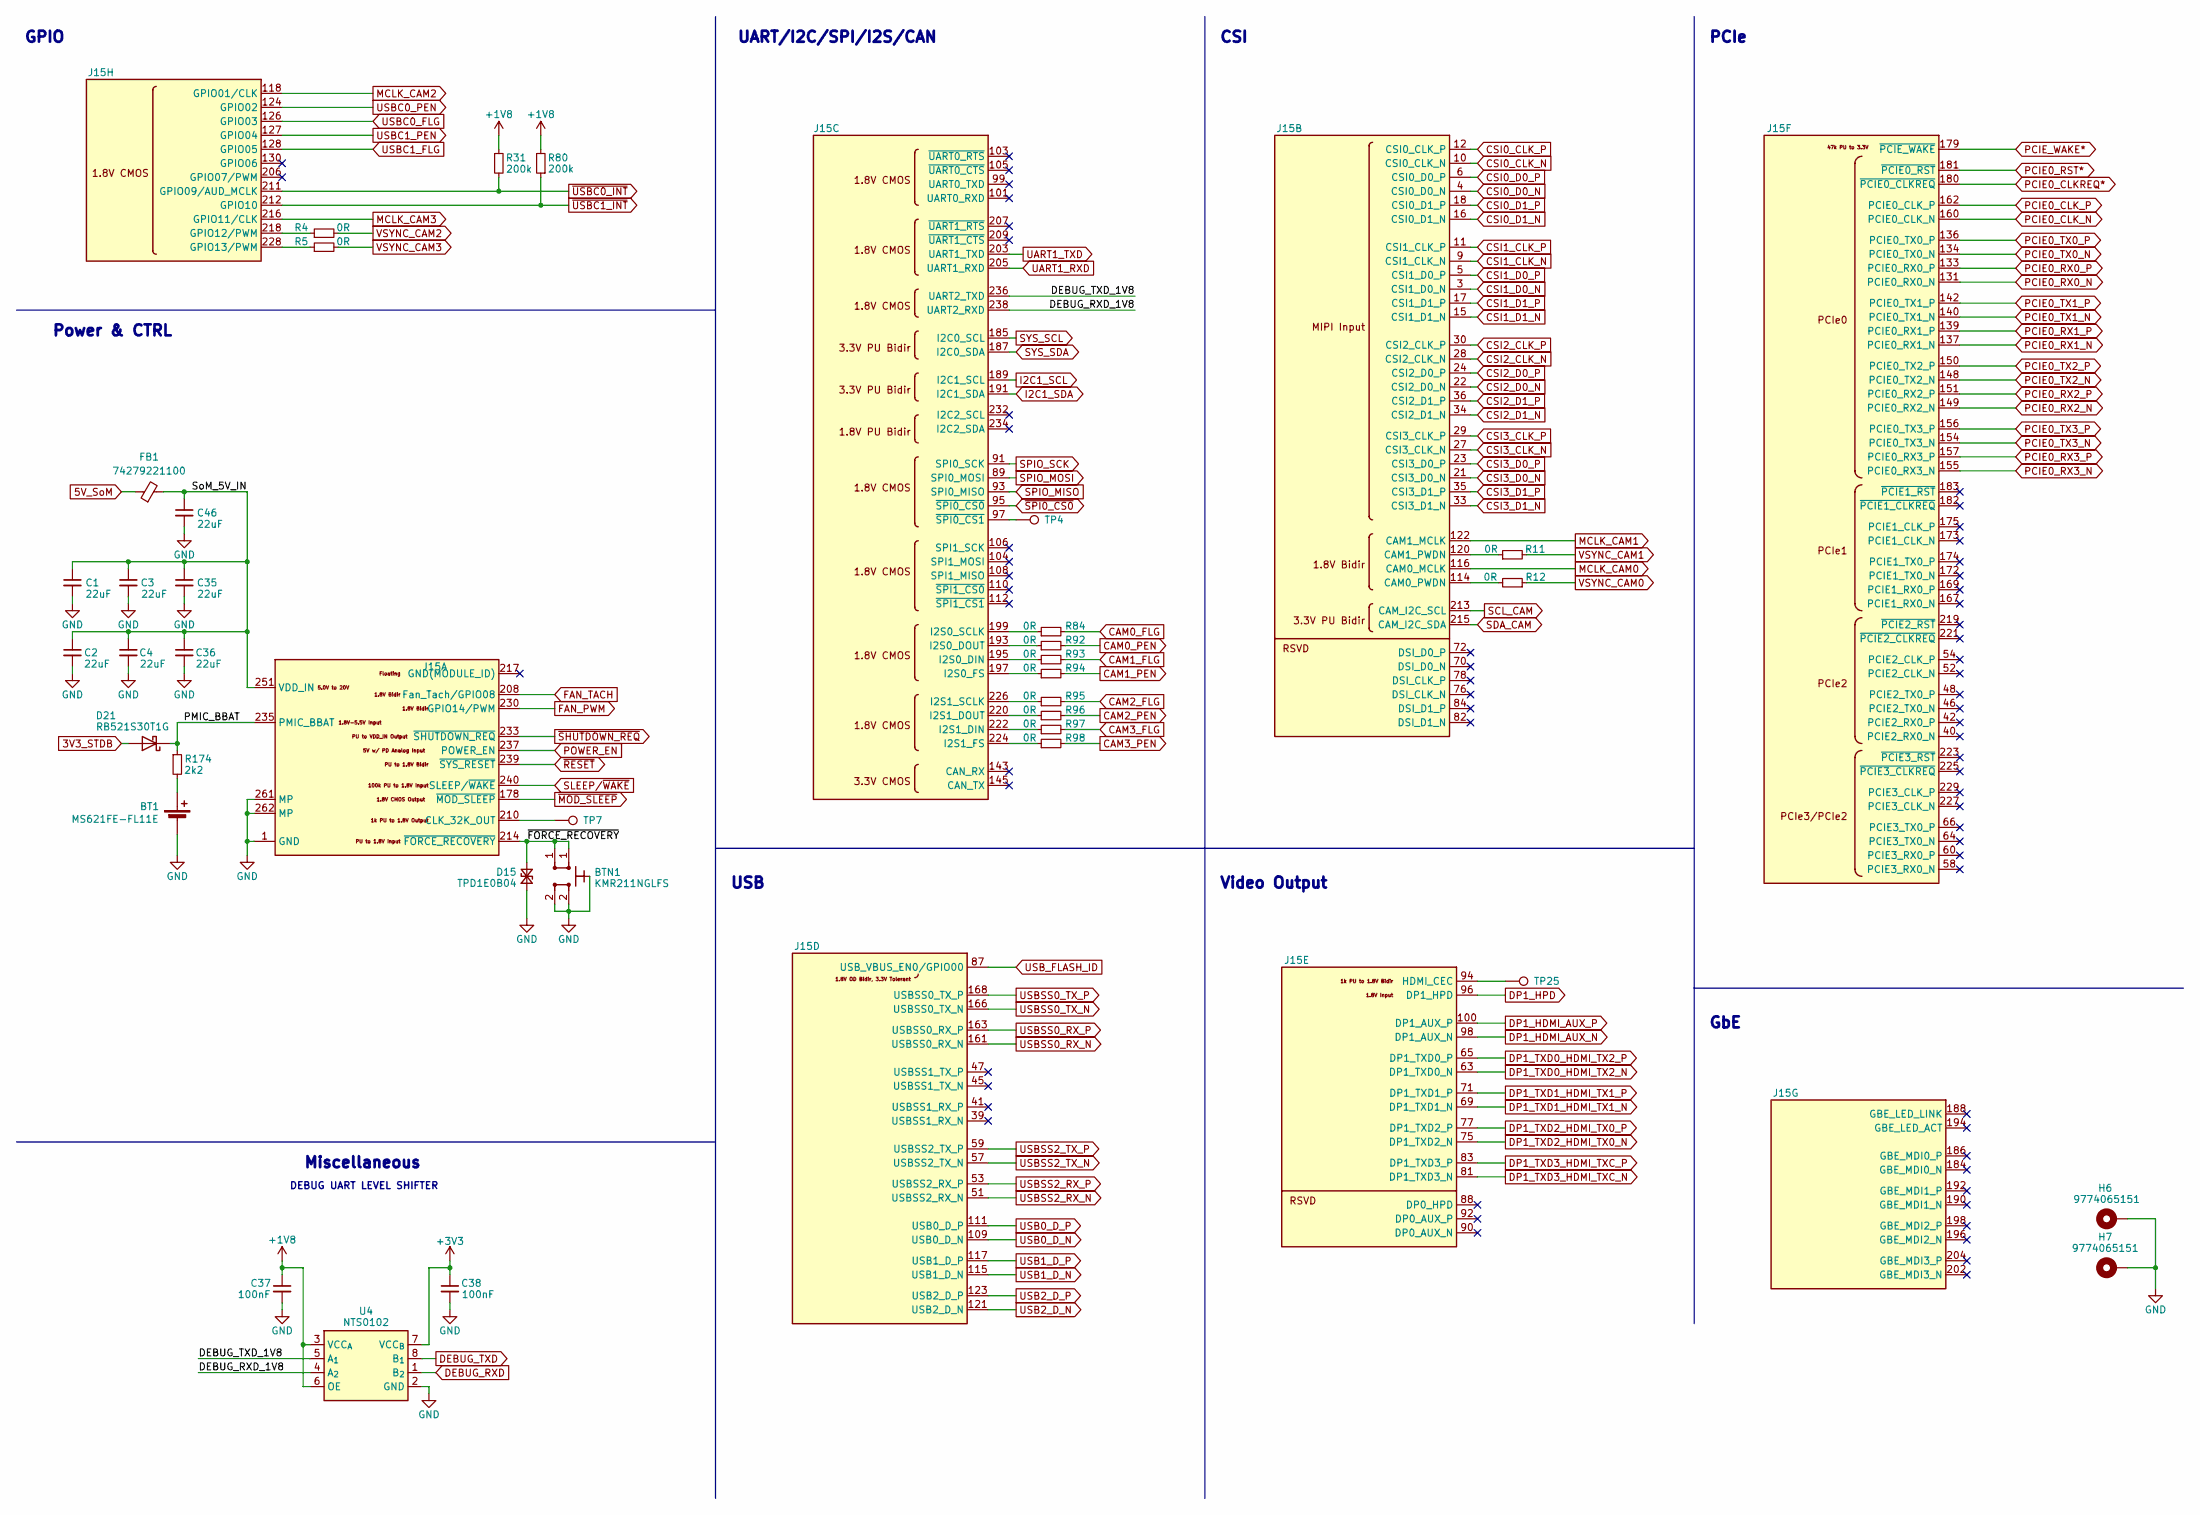
[picture p7: schematic som.kicad_sch]

Parts:
BT1: MS621FE-FL11E; MPN MS621FE-FL11E
BTN1: KMR211NGLFS; SW_Push_1P1T-SH_NO_CK_KMR2xxG; MPN KMR211NGLFS
C1, C2, C3, C4, C35, C36, C46: 22uF; C_0603_1608Metric; Voltage 16V; MPN CL10A226MO7JZNC
C37, C38: 100nF; C_0603_1608Metric; Voltage 50V; MPN GRM155R61H104KE14D
D15: TPD1E0B04; D_SOD-882; MPN TPD1E0B04
D21: RB521S30T1G; D_SOD-523; MPN RB521S30T1G
FB1: 74279221100; L_1206_3216Metric; MPN 74279221100
H6, H7: 9774065151; Spacer_Drill3.7mm_H2.5mm_9774025151R; MPN 9774025151R
J15: Bus_DDR4_SODIMM_CUSTOM_Jetson-Orin-H9.2mm-socket; TE_2309413; MPN 2309413-1
R4, R5, R11, R12, R84, R92, R93, R94, R95, R96, R97, R98: 0R; R_0402_1005Metric; MPN ERJ2GE0R00X
R31, R80: 200k; R_0402_1005Metric; Tolerance 1%; MPN CR0402-FX-4701GLF
R174: 2k2; R_0402_1005Metric; Tolerance 1%; MPN CR0402-FX-2201GLF
TP4, TP7, TP25: TP_0.75mm_SMD; TP_SMD_0.75mm
U4: NTS0102; XSON-8_1x1.95mm_P0.5mm; MPN NTS0102GT

Connections:
3V3_STDB: D21.2 (A)
5V_SoM: FB1.1
+1V8: C37.1, R31.1, R80.2, U4.3 (VCC_{A}), U4.6 (OE)
+3V3: C38.1, U4.7 (VCC_{B})
CAM0_FLG: R84.2
CAM0_PEN: R92.2
CAM1_FLG: R93.2
CAM1_PEN: R94.2
CAM2_FLG: R95.2
CAM2_PEN: R96.2
CAM3_FLG: R97.2
CAM3_PEN: R98.2
CSI0_CLK_N: J15.10 (CSI0_CLK_N)
CSI0_CLK_P: J15.12 (CSI0_CLK_P)
CSI0_D0_N: J15.4 (CSI0_D0_N)
CSI0_D0_P: J15.6 (CSI0_D0_P)
CSI0_D1_N: J15.16 (CSI0_D1_N)
CSI0_D1_P: J15.18 (CSI0_D1_P)
CSI1_CLK_N: J15.9 (CSI1_CLK_N)
CSI1_CLK_P: J15.11 (CSI1_CLK_P)
CSI1_D0_N: J15.3 (CSI1_D0_N)
CSI1_D0_P: J15.5 (CSI1_D0_P)
CSI1_D1_N: J15.15 (CSI1_D1_N)
CSI1_D1_P: J15.17 (CSI1_D1_P)
CSI2_CLK_N: J15.28 (CSI2_CLK_N)
CSI2_CLK_P: J15.30 (CSI2_CLK_P)
CSI2_D0_N: J15.22 (CSI2_D0_N)
CSI2_D0_P: J15.24 (CSI2_D0_P)
CSI2_D1_N: J15.34 (CSI2_D1_N)
CSI2_D1_P: J15.36 (CSI2_D1_P)
CSI3_CLK_N: J15.27 (CSI3_CLK_N)
CSI3_CLK_P: J15.29 (CSI3_CLK_P)
CSI3_D0_N: J15.21 (CSI3_D0_N)
CSI3_D0_P: J15.23 (CSI3_D0_P)
CSI3_D1_N: J15.33 (CSI3_D1_N)
CSI3_D1_P: J15.35 (CSI3_D1_P)
DEBUG_RXD: U4.1 (B_{2})
DEBUG_RXD_1V8: J15.238 (UART2_RXD), U4.4 (A_{2})
DEBUG_TXD: U4.8 (B_{1})
DEBUG_TXD_1V8: J15.236 (UART2_TXD), U4.5 (A_{1})
DP1_HDMI_AUX_N: J15.98 (DP1_AUX_N)
DP1_HDMI_AUX_P: J15.100 (DP1_AUX_P)
DP1_HPD: J15.96 (DP1_HPD)
DP1_TXD0_HDMI_TX2_N: J15.63 (DP1_TXD0_N)
DP1_TXD0_HDMI_TX2_P: J15.65 (DP1_TXD0_P)
DP1_TXD1_HDMI_TX1_N: J15.69 (DP1_TXD1_N)
DP1_TXD1_HDMI_TX1_P: J15.71 (DP1_TXD1_P)
DP1_TXD2_HDMI_TX0_N: J15.75 (DP1_TXD2_N)
DP1_TXD2_HDMI_TX0_P: J15.77 (DP1_TXD2_P)
DP1_TXD3_HDMI_TXC_N: J15.81 (DP1_TXD3_N)
DP1_TXD3_HDMI_TXC_P: J15.83 (DP1_TXD3_P)
FAN_PWM: J15.230 (GPIO14/PWM)
FAN_TACH: J15.208 (Fan_Tach/GPIO08)
GND: BT1.2 (-), BTN1.2, BTN1.SH, C1.2, C2.2, C3.2, C4.2, C35.2, C36.2, C37.2, C38.2, C46.2, D15.1 (A1), H6.1, H7.1, J15.1 (GND), J15.2 (GND), J15.7 (GND), J15.8 (GND), J15.13 (GND), J15.14 (GND), J15.19 (GND), J15.20 (GND), J15.25 (GND), J15.26 (GND), J15.31 (GND), J15.32 (GND), J15.37 (GND), J15.38 (GND), J15.43 (GND), J15.44 (GND), J15.49 (GND), J15.50 (GND), J15.55 (GND), J15.56 (GND), J15.61 (GND), J15.62 (GND), J15.67 (GND), J15.68 (GND), J15.73 (GND), J15.74 (GND), J15.79 (GND), J15.80 (GND), J15.85 (GND), J15.86 (GND), J15.102 (GND), J15.107 (GND), J15.113 (GND), J15.119 (GND), J15.125 (GND), J15.129 (GND), J15.132 (GND), J15.135 (GND), J15.138 (GND), J15.141 (GND), J15.144 (GND), J15.146 (GND), J15.147 (GND), J15.152 (GND), J15.153 (GND), J15.158 (GND), J15.159 (GND), J15.164 (GND), J15.165 (GND), J15.170 (GND), J15.171 (GND), J15.176 (GND), J15.177 (GND), J15.200 (GND), J15.201 (GND), J15.231 (GND), J15.241 (GND), J15.242 (GND), J15.243 (GND), J15.244 (GND), J15.245 (GND), J15.246 (GND), J15.247 (GND), J15.248 (GND), J15.249 (GND), J15.250 (GND), J15.261 (MP), J15.262 (MP), U4.2 (GND)
I2C1_SCL: J15.189 (I2C1_SCL)
I2C1_SDA: J15.191 (I2C1_SDA)
MCLK_CAM0: J15.116 (CAM0_MCLK)
MCLK_CAM1: J15.122 (CAM1_MCLK)
MCLK_CAM2: J15.118 (GPIO01/CLK)
MCLK_CAM3: J15.216 (GPIO11/CLK)
unnamed: BT1.1 (+), R174.2
unnamed: J15.94 (HDMI_CEC), TP25.1
unnamed: J15.97 (~SPI0_CS1), TP4.1
unnamed: J15.114 (CAM0_PWDN), R12.2
unnamed: J15.120 (CAM1_PWDN), R11.1
unnamed: J15.193 (I2S0_DOUT), R92.1
unnamed: J15.195 (I2S0_DIN), R93.1
unnamed: J15.197 (I2S0_FS), R94.1
unnamed: J15.199 (I2S0_SCLK), R84.1
unnamed: J15.210 (CLK_32K_OUT), TP7.1
unnamed: J15.218 (GPIO12/PWM), R4.1
unnamed: J15.220 (I2S1_DOUT), R96.1
unnamed: J15.222 (I2S1_DIN), R97.1
unnamed: J15.224 (I2S1_FS), R98.1
unnamed: J15.226 (I2S1_SCLK), R95.1
unnamed: J15.228 (GPIO13/PWM), R5.1
PCIE0_CLKREQ*: J15.180 (~PCIE0_CLKREQ)
PCIE0_CLK_N: J15.160 (PCIE0_CLK_N)
PCIE0_CLK_P: J15.162 (PCIE0_CLK_P)
PCIE0_RST*: J15.181 (~PCIE0_RST)
PCIE0_RX0_N: J15.131 (PCIE0_RX0_N)
PCIE0_RX0_P: J15.133 (PCIE0_RX0_P)
PCIE0_RX1_N: J15.137 (PCIE0_RX1_N)
PCIE0_RX1_P: J15.139 (PCIE0_RX1_P)
PCIE0_RX2_N: J15.149 (PCIE0_RX2_N)
PCIE0_RX2_P: J15.151 (PCIE0_RX2_P)
PCIE0_RX3_N: J15.155 (PCIE0_RX3_N)
PCIE0_RX3_P: J15.157 (PCIE0_RX3_P)
PCIE0_TX0_N: J15.134 (PCIE0_TX0_N)
PCIE0_TX0_P: J15.136 (PCIE0_TX0_P)
PCIE0_TX1_N: J15.140 (PCIE0_TX1_N)
PCIE0_TX1_P: J15.142 (PCIE0_TX1_P)
PCIE0_TX2_N: J15.148 (PCIE0_TX2_N)
PCIE0_TX2_P: J15.150 (PCIE0_TX2_P)
PCIE0_TX3_N: J15.154 (PCIE0_TX3_N)
PCIE0_TX3_P: J15.156 (PCIE0_TX3_P)
PCIE_WAKE*: J15.179 (~PCIE_WAKE)
PMIC_BBAT: D21.1 (K), J15.235 (PMIC_BBAT), R174.1
POWER_EN: J15.237 (POWER_EN)
SCL_CAM: J15.213 (CAM_I2C_SCL)
SDA_CAM: J15.215 (CAM_I2C_SDA)
SLEEP/~WAKE: J15.240 (SLEEP/~WAKE)
SPIO_MISO: J15.93 (SPI0_MISO)
SPIO_MOSI: J15.89 (SPI0_MOSI)
SPIO_SCK: J15.91 (SPI0_SCK)
SYS_SCL: J15.185 (I2C0_SCL)
SYS_SDA: J15.187 (I2C0_SDA)
SoM_5V_IN: C1.1, C2.1, C3.1, C4.1, C35.1, C36.1, C46.1, FB1.2, J15.251 (VDD_IN), J15.252 (VDD_IN), J15.253 (VDD_IN), J15.254 (VDD_IN), J15.255 (VDD_IN), J15.256 (VDD_IN), J15.257 (VDD_IN), J15.258 (VDD_IN), J15.259 (VDD_IN), J15.260 (VDD_IN)
UART1_RXD: J15.205 (UART1_RXD)
UART1_TXD: J15.203 (UART1_TXD)
USB0_D_N: J15.109 (USB0_D_N)
USB0_D_P: J15.111 (USB0_D_P)
USB1_D_N: J15.115 (USB1_D_N)
USB1_D_P: J15.117 (USB1_D_P)
USB2_D_N: J15.121 (USB2_D_N)
USB2_D_P: J15.123 (USB2_D_P)
USBC0_FLG: J15.126 (GPIO03)
USBC0_PEN: J15.124 (GPIO02)
USBC1_FLG: J15.128 (GPIO05)
USBC1_PEN: J15.127 (GPIO04)
USBSS0_RX_N: J15.161 (USBSS0_RX_N)
USBSS0_RX_P: J15.163 (USBSS0_RX_P)
USBSS0_TX_N: J15.166 (USBSS0_TX_N)
USBSS0_TX_P: J15.168 (USBSS0_TX_P)
USBSS2_RX_N: J15.51 (USBSS2_RX_N)
USBSS2_RX_P: J15.53 (USBSS2_RX_P)
USBSS2_TX_N: J15.57 (USBSS2_TX_N)
USBSS2_TX_P: J15.59 (USBSS2_TX_P)
USB_FLASH_ID: J15.87 (USB_VBUS_EN0/GPIO00)
VSYNC_CAM0: R12.1
VSYNC_CAM1: R11.2
VSYNC_CAM2: R4.2
VSYNC_CAM3: R5.2
~FORCE_RECOVERY: BTN1.1, D15.2 (A2), J15.214 (~FORCE_RECOVERY)
~MOD_SLEEP: J15.178 (~MOD_SLEEP)
~RESET: J15.239 (~SYS_RESET)
~SHUTDOWN_REQ: J15.233 (~SHUTDOWN_REQ)
~SPI0_CS0: J15.95 (~SPI0_CS0)
~USBC0_INT: J15.211 (GPIO09/AUD_MCLK), R31.2
~USBC1_INT: J15.212 (GPIO10), R80.1

Notes on the sheet:
DEBUG UART LEVEL SHIFTER
CSI
Video Output
Power & CTRL
UART/I2C/SPI/I2S/CAN
PCIe
GbE
USB
GPIO
Miscellaneous
