cmu-argus-1/Avionics-JetsonCarrier/supply.kicad_sch

## KiCad design supply.kicad_sch (2024-07-27)

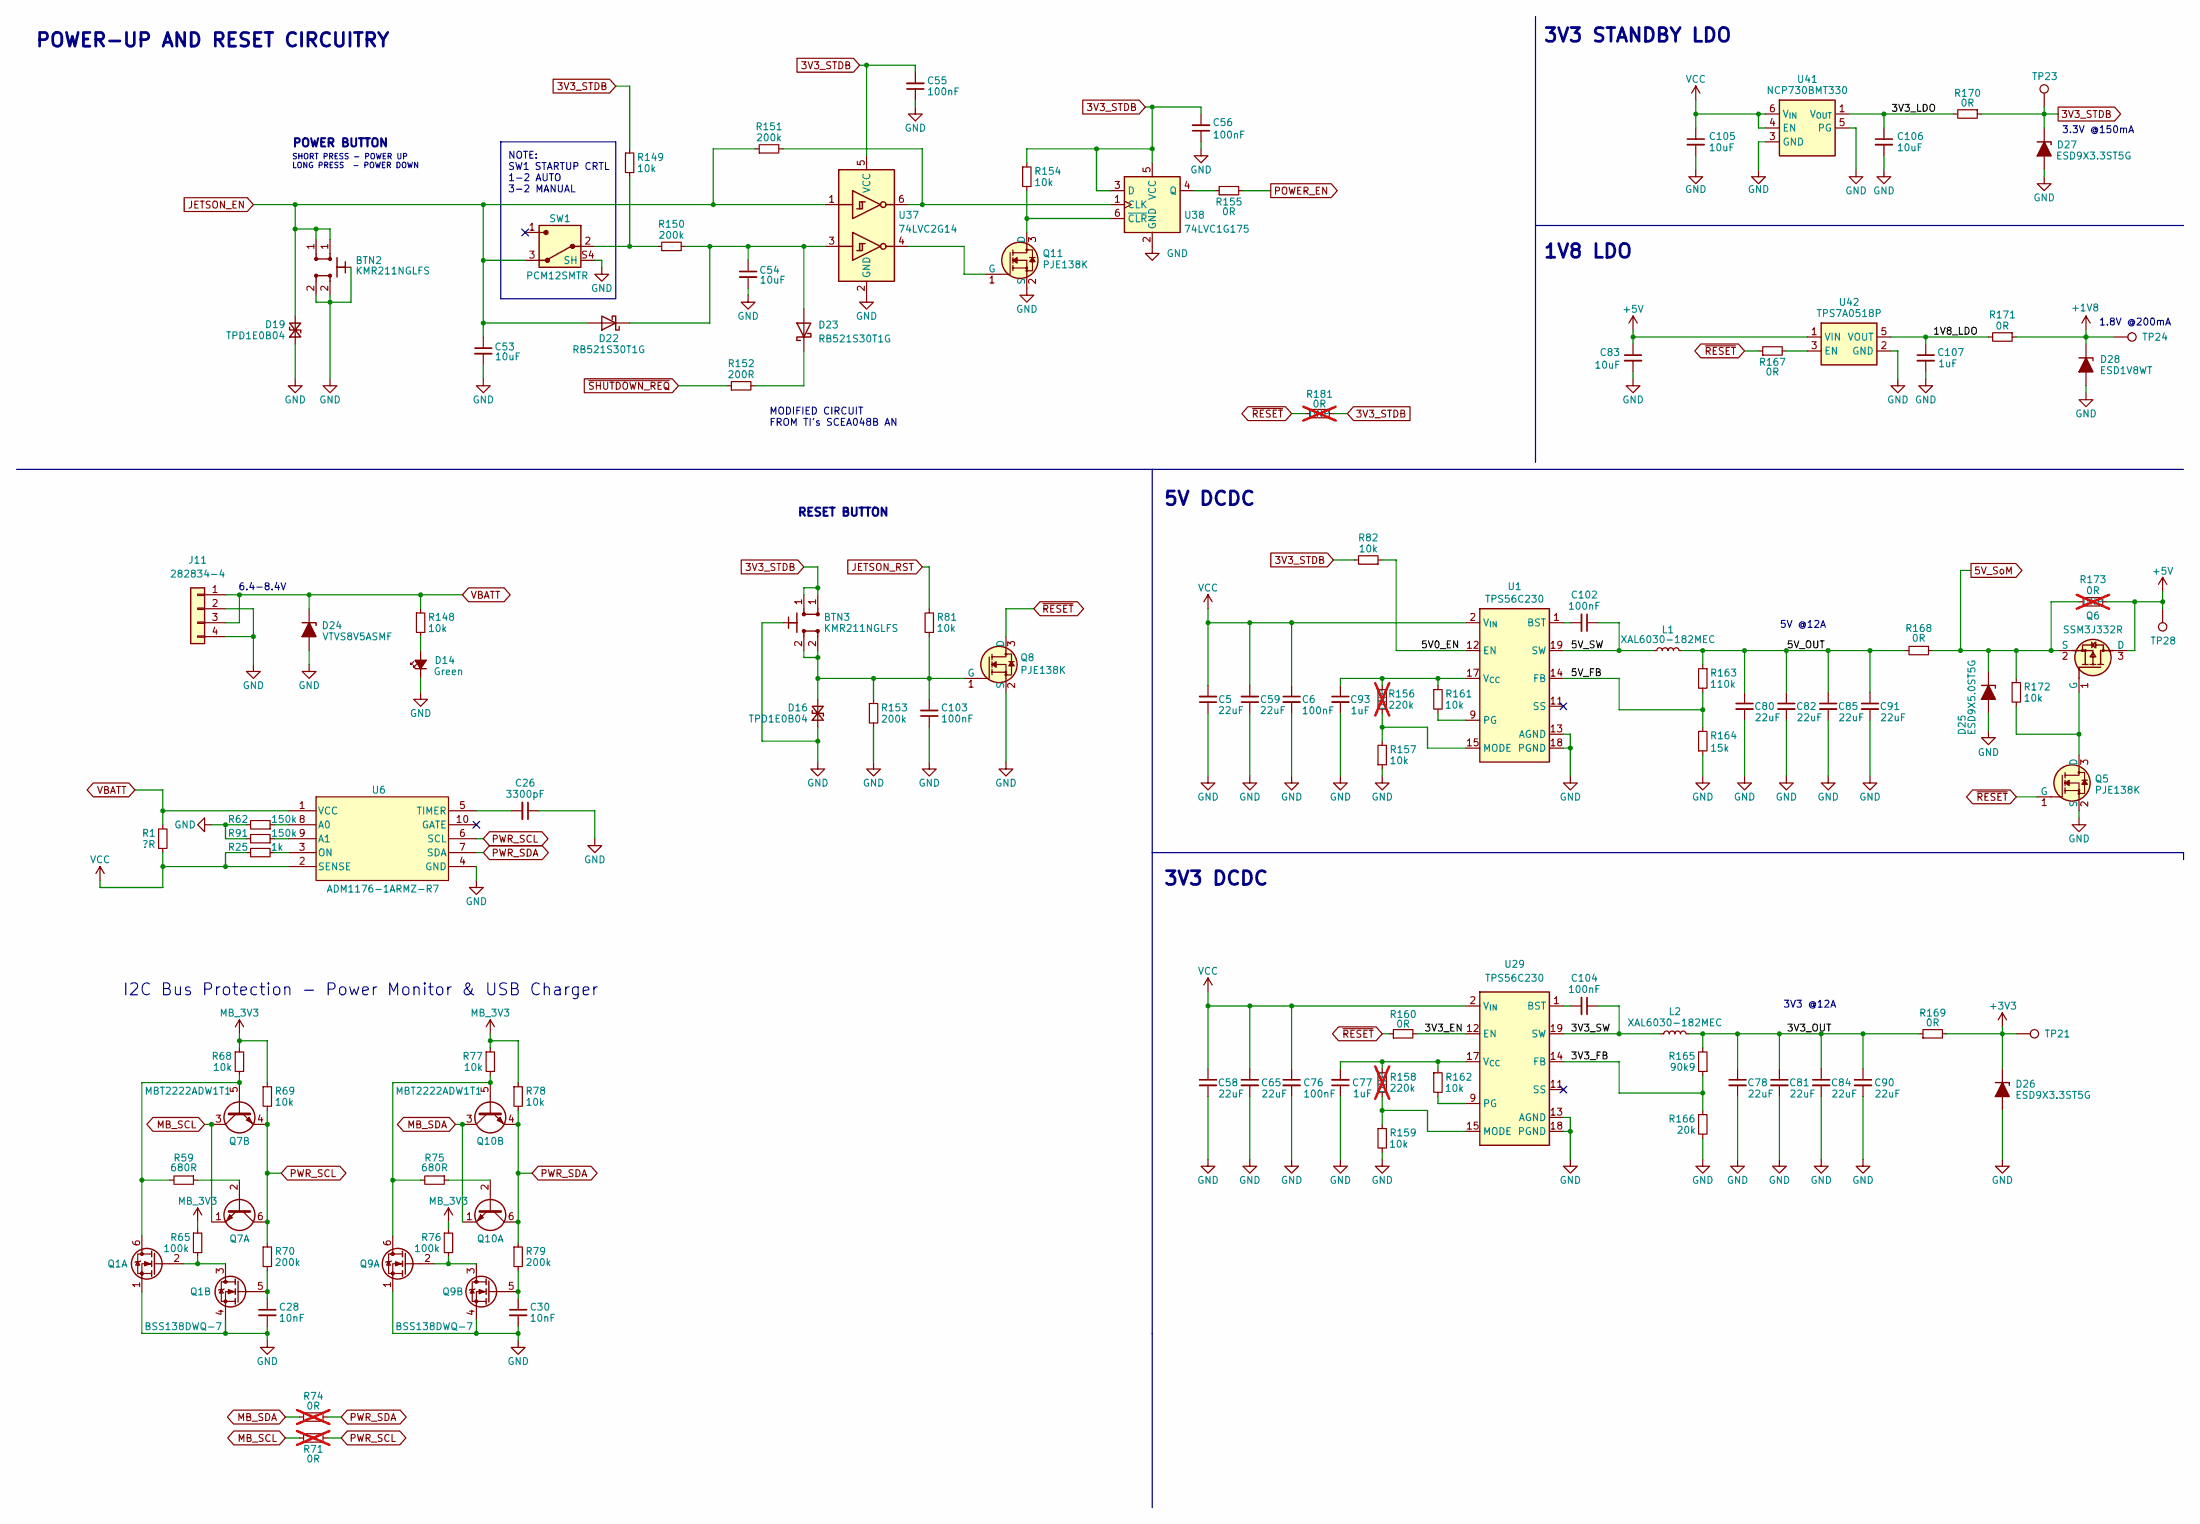
[picture p8: schematic supply.kicad_sch]

Parts:
BTN2, BTN3: KMR211NGLFS; SW_Push_1P1T-SH_NO_CK_KMR2xxG; MPN KMR211NGLFS
C5, C58, C59, C65: 22uF; C_0805_2012Metric; Voltage 25V; MPN CL21A226MAYNNNE
C6, C55, C56, C76, C102, C103, C104: 100nF; C_0603_1608Metric; Voltage 50V; MPN GRM155R61H104KE14D
C26: 3300pF; C_0603_1608Metric
C28, C30: 10nF; C_0603_1608Metric
C53, C54, C83, C106: 10uF; C_0603_1608Metric; MPN CC0402MRX5R5BB106
C77, C93, C107: 1uF; C_0603_1608Metric; MPN C1005X6S1A105K050BC
C78, C80, C81, C82, C84, C85, C90, C91: 22uF; C_0603_1608Metric; Voltage 16V; MPN CL10A226MO7JZNC
C105: 10uF; C_0603_1608Metric; MPN C1608X5R1E106M080AC
D14: LED_G_0603_LTST-C190GKT; LED_0603_1608Metric; MPN LTST-C190GKT
D16, D19: TPD1E0B04; D_SOD-882; MPN TPD1E0B04DPYR
D22, D23: RB521S30T1G; D_SOD-523; MPN RB521S30T1G
D24: VTVS8V5ASMF; D_SMF; MPN DF2S30FS
D25: ESD9X5.0ST5G; D_SOD-923; MPN ESD9X5.0ST5G
D26, D27: ESD9X3.3ST5G; D_SOD-923; MPN ESD9X5.0ST5G
D28: ESD1V8WT; D_SOD-523; MPN ESD9X5.0ST5G
J11: 282834-4; TE_282834-4
L1, L2: XAL6030-182MEC; L_Coilcraft_XAL6030-XXX; MPN XAL6030-182MEC
Q1, Q9: BSS138DWQ-7; SOT-363_SC-70-6; Manufacturer_Part_Number BSS138DWQ-7
Q5, Q8, Q11: PJE138K; SOT-523; MPN PJE138K_R1_00001
Q6: SSM3J332R; SOT-23-3; MPN SSM3J332R,LF
Q7, Q10: MBT2222ADW1T1; SOT-363_SC-70-6; Manufacturer_Part_Number MBT2222ADW1T1G
R1: ?R; R_2512_6332Metric
R25: 1k; R_0603_1608Metric
R59, R75: 680R; R_0603_1608Metric
R62, R91: 150k; R_0603_1608Metric
R65, R76: 100k; R_0603_1608Metric
R68, R69, R77, R78: 10k; R_0603_1608Metric
R70, R79: 200k; R_0603_1608Metric
R71, R74: 0R; R_0603_1608Metric; not fitted
R81: 10k; R_0603_1608Metric; Tolerance 1%; MPN CR0402-FX-2003GLF
R82, R148, R154, R157, R159, R161, R162, R172: 10k; R_0603_1608Metric; Tolerance 1%; MPN CR0402-FX-1002GLF
R149: 10k; R_0603_1608Metric; Tolerance 1%; MPN CR0402-FX-1001GLF
R150, R151, R153: 200k; R_0603_1608Metric; Tolerance 1%; MPN CR0402-FX-2003GLF
R152: 200R; R_0603_1608Metric; Tolerance 1%; MPN CR0402-FX-2000GLF
R155, R160, R167: 0R; R_0603_1608Metric; MPN ERJ2GE0R00X
R156, R158: 220k; R_0603_1608Metric; Tolerance 1%; MPN CR0402-FX-2203GLF; not fitted
R163: 110k; R_0603_1608Metric; Tolerance 1%; MPN CR0402-FX-1103GLF
R164: 15k; R_0603_1608Metric; Tolerance 1%; MPN CR0402-FX-1502GLF
R165: 90k9; R_0603_1608Metric; Tolerance 1%; MPN CR0402-FX-9092GLF
R166: 20k; R_0603_1608Metric; Tolerance 1%; MPN CR0402-FX-2002GLF
R168, R169: 0R; R_0805_2012Metric; MPN PMR03EZPJ000
R170, R171: 0R; R_0603_1608Metric; MPN CR0603-J/-000ELF
R173: 0R; R_0805_2012Metric; MPN PMR03EZPJ000; not fitted
R181: 0R; R_0402_1005Metric; MPN ERJ2GE0R00X; not fitted
SW1: PCM12SMTR; SW_SPDT_PCM12; MPN PCM12SMTR
TP21, TP23, TP24, TP28: TP_0.75mm_SMD; TP_SMD_0.75mm
U1, U29: TPS56C230; QFN-20-1EP_3x3mm_P0.45mm; MPN TPS56C230RJER
U6: ADM1176-1ARMZ-R7; MSOP-10_3x3mm_P0.5mm; Manufacturer_Part_Number ADM1176-1ARMZ-R7
U37: 74LVC2G14; SOT-23-6; MPN 74LVC2G14GV,125
U38: 74LVC1G175; SOT-23-6; MPN 74LVC1G175GV,125
U41: NCP730BMT330; WSON-6-1EP_2x2mm_P0.65mm; MPN NCP730BMT330TBG
U42: TPS7A0518P; SOT-23-5; MPN TPS7A0518PDBVT

Connections:
1V8_LDO: C107.1, R171.2, U42.5 (VOUT)
3V3_EN: R160.2, U29.12 (EN)
3V3_FB: R165.1, R166.1, U29.14 (FB)
3V3_LDO: C106.1, R170.2, U41.1 (V_{OUT})
3V3_OUT: C78.1, C81.1, C84.1, C90.1, L2.2, R165.2, R169.1
3V3_STDB: BTN3.1, C55.2, C56.2, D27.1 (K), R82.2, R149.1, R154.1, R170.1, R181.2, TP23.1, U37.5 (VCC), U38.3 (D), U38.5 (VCC)
3V3_SW: C104.1, L2.1, U29.6 (SW), U29.19 (SW), U29.20 (SW)
5V0_EN: R82.1, U1.12 (EN)
5V_FB: R163.2, R164.2, U1.14 (FB)
5V_OUT: C80.1, C82.1, C85.1, C91.1, L1.2, R163.1, R168.2
5V_SW: C102.1, L1.1, U1.6 (SW), U1.19 (SW), U1.20 (SW)
5V_SoM: D25.1 (K), Q6.2 (S), R168.1, R172.1, R173.1
+1V8: D28.1 (K), R171.1, TP24.1
+3V3: D26.1 (K), R169.2, TP21.1
+5V: C83.1, Q6.3 (D), R173.2, TP28.1, U42.1 (VIN)
GND: BTN2.2, BTN2.SH, BTN3.SH, C5.1, C6.2, C26.1, C28.2, C30.2, C53.2, C54.2, C55.1, C56.1, C58.2, C59.1, C65.2, C76.2, C77.1, C78.2, C80.2, C81.2, C82.2, C83.2, C84.2, C85.2, C90.2, C91.2, C93.2, C103.1, C105.2, C106.2, C107.2, D14.1 (K), D16.1 (A1), D19.1 (A1), D24.2 (A), D25.2 (A), D26.2 (A), D27.2 (A), D28.2 (A), J11.2, J11.4, Q1.1 (S2), Q1.4 (S1), Q5.2 (S), Q8.2 (S), Q9.1 (S2), Q9.4 (S1), Q11.2 (S), R62.2, R91.2, R153.2, R157.1, R159.2, R164.1, R166.2, SW1.S1 (SH), SW1.S2 (SH), SW1.S3 (SH), SW1.S4 (SH), U1.7 (PGND), U1.8 (PGND), U1.13 (AGND), U1.18 (PGND), U1.21 (PGND), U6.4 (GND), U29.7 (PGND), U29.8 (PGND), U29.13 (AGND), U29.18 (PGND), U29.21 (PGND), U37.2 (GND), U38.2 (GND), U41.3 (GND), U41.5 (PG), U41.7 (GND), U42.2 (GND)
JETSON_EN: BTN2.1, C53.1, D19.2 (A2), D22.2 (A), R151.1, SW1.3, U37.1
JETSON_RST: R81.2
MB_3V3: R65.1, R68.1, R69.1, R76.1, R77.1, R78.1
MB_SCL: Q7.1 (E1), Q7.3 (C2), R71.1
MB_SDA: Q10.1 (E1), Q10.3 (C2), R74.1
unnamed: BTN3.2, C103.2, D16.2 (A2), Q8.1 (G), R81.1, R153.1
unnamed: C26.2, U6.5 (TIMER)
unnamed: C28.1, Q1.5 (G1), R70.2
unnamed: C30.1, Q9.5 (G1), R79.2
unnamed: C54.1, D22.1 (K), D23.2 (A), R150.2, U37.3
unnamed: C77.2, R158.2, R162.1, U29.17 (V_{CC})
unnamed: C93.1, R156.1, R161.1, U1.17 (V_{CC})
unnamed: C102.2, U1.1 (BST)
unnamed: C104.2, U29.1 (BST)
unnamed: D14.2 (A), R148.2
unnamed: D23.1 (K), R152.2
unnamed: Q1.2 (G2), Q1.3 (D2), R65.2
unnamed: Q1.6 (D1), Q7.5 (B2), R59.2, R68.2
unnamed: Q5.3 (D), Q6.1 (G), R172.2
unnamed: Q7.2 (B1), R59.1
unnamed: Q9.2 (G2), Q9.3 (D2), R76.2
unnamed: Q10.2 (B1), R75.1
unnamed: Q9.6 (D1), Q10.5 (B2), R75.2, R77.2
unnamed: Q11.1 (G), U37.4
unnamed: Q11.3 (D), R154.2, U38.6 (~CLR)
unnamed: R25.2, U6.3 (ON)
unnamed: R62.1, U6.8 (A0)
unnamed: R91.1, U6.9 (A1)
unnamed: R149.2, R150.1, SW1.2
unnamed: R151.2, U37.6, U38.1 (CLK)
unnamed: R155.1, U38.4 (Q)
unnamed: R156.2, R157.2, U1.15 (MODE)
unnamed: R158.1, R159.1, U29.15 (MODE)
unnamed: R161.2, U1.9 (PG)
unnamed: R162.2, U29.9 (PG)
unnamed: R167.2, U42.3 (EN)
POWER_EN: R155.2
PWR_SCL: Q7.4 (E2), Q7.6 (C1), R69.2, R70.1, R71.2, U6.6 (SCL)
PWR_SDA: Q10.4 (E2), Q10.6 (C1), R74.2, R78.2, R79.1, U6.7 (SDA)
VBATT: D24.1 (K), J11.1, J11.3, R1.2, R148.1, U6.1 (VCC)
VCC: C5.2, C6.1, C58.1, C59.2, C65.1, C76.1, C105.1, R1.1, R25.1, U1.2 (V_{IN}), U1.3 (V_{IN}), U1.4 (V_{IN}), U1.5 (V_{IN}), U6.2 (SENSE), U29.2 (V_{IN}), U29.3 (V_{IN}), U29.4 (V_{IN}), U29.5 (V_{IN}), U41.4 (EN), U41.6 (V_{IN})
~RESET: Q5.1 (G), Q8.3 (D), R160.1, R167.1, R181.1
~SHUTDOWN_REQ: R152.1

Notes on the sheet:
5V @12A
I2C Bus Protection - Power Monitor & USB Charger
3V3 STANDBY LDO
3.3V @150mA
MODIFIED CIRCUIT FROM TI's SCEA048B AN
1V8 LDO
SHORT PRESS - POWER UP LONG PRESS - POWER DOWN
5V DCDC
NOTE: SW1 STARTUP CRTL 1-2 AUTO 3-2 MANUAL
POWER BUTTON
POWER-UP AND RESET CIRCUITRY
3V3 @12A
6.4-8.4V
3V3 DCDC
1.8V @200mA
RESET BUTTON
