cmu-argus-1/Avionics-JetsonCarrier/usb3.kicad_sch

## KiCad design usb3.kicad_sch (2024-07-25)

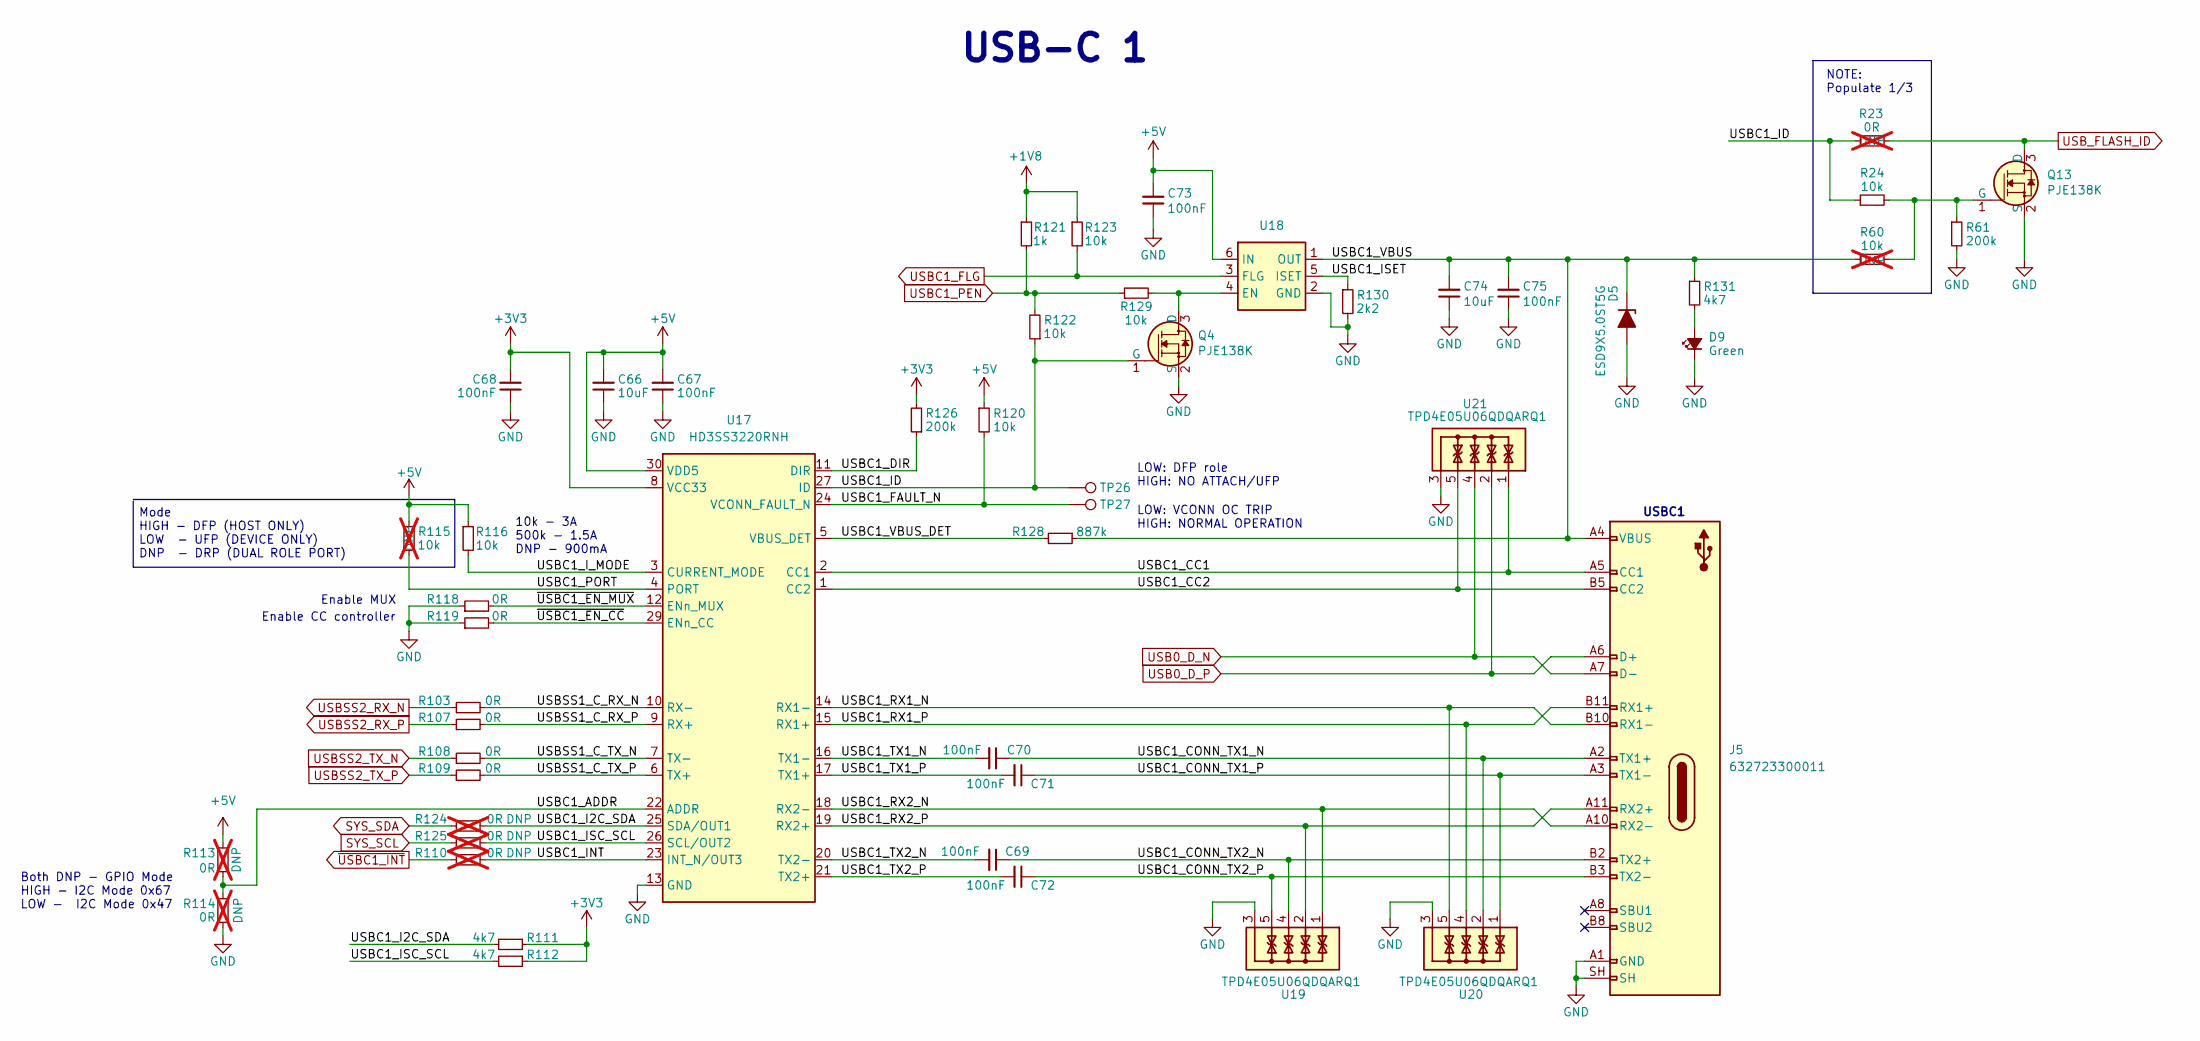
[picture p9: schematic usb3.kicad_sch]

Parts:
C66: 10uF; C_0402_1005Metric; MPN GRM188R61A106KE69D
C67, C68, C69, C70, C71, C72: 100nF; C_0402_1005Metric; Voltage 50V; MPN GRM155R61H104KE14D
C73, C75: 100nF; C_0603_1608Metric; Voltage 50V; MPN GRM155R61H104KE14D
C74: 10uF; C_0603_1608Metric; MPN GRM188R61A106KE69D
D5: ESD9X5.0ST5G; D_SOD-923; MPN ESD9X5.0ST5G
D9: LED_G_0603_LTST-C190GKT; LED_0603_1608Metric; MPN LTST-C190GKT
J5: 632723300011; USB-C_Receptacle_WE_632723300011; MPN 632723300011
Q4, Q13: PJE138K; SOT-523; MPN PJE138K_R1_00001
R23: 0R; R_0603_1608Metric; MPN ERJ2GE0R00X; not fitted
R24: 10k; R_0603_1608Metric; Tolerance 1%; MPN CR0402-FX-1002GLF
R60: 10k; R_0603_1608Metric; Tolerance 1%; MPN CR0402-FX-1002GLF; not fitted
R61: 200k; R_0603_1608Metric; Tolerance 1%; MPN CR0402-FX-2003GLF
R103, R107, R108, R109, R118, R119: 0R; R_0402_1005Metric; MPN ERJ2GE0R00X
R110, R113, R114, R124, R125: 0R; R_0402_1005Metric; MPN ERJ2GE0R00X; not fitted
R111, R112: 4k7; R_0402_1005Metric; Tolerance 1%; MPN CR0402-FX-2003GLF
R115: 10k; R_0402_1005Metric; Tolerance 1%; MPN CR0402-FX-1002GLF; not fitted
R116, R120, R122, R123, R129: 10k; R_0402_1005Metric; Tolerance 1%; MPN CR0402-FX-1002GLF
R121: 1k; R_0402_1005Metric; Tolerance 1%; MPN CR0402-FX-1001GLF
R126: 200k; R_0402_1005Metric; Tolerance 1%; MPN CR0402-FX-2003GLF
R128: 887k; R_0402_1005Metric; Tolerance 1%; MPN ERJ-2RKF8873X
R130: 2k2; R_0402_1005Metric; Tolerance 1%; MPN CR0402-FX-2201GLF
R131: 4k7; R_0402_1005Metric; Tolerance 1%; MPN CR0402-FX-4700GLF
TP26, TP27: TP_0.75mm_SMD; TP_SMD_0.75mm
U17: HD3SS3220RNH; WQFN-30-1EP_4.6x2.6mm_P0.4mm; MPN HD3SS3220RNHT
U18: AP22615A_TSOT26; TSOT-23-6; MPN AP22615AWU-7
U19, U20, U21: TPD4E05U06QDQARQ1; USON-10_2.5x1mm_P0.5mm; MPN TPD4E05U06QDQARQ1

Connections:
+1V8: R121.1, R123.1
+3V3: C68.2, R111.1, R112.1, R126.2, U17.8 (VCC33)
+5V: C66.2, C67.2, C73.2, R113.2, R115.2, R116.1, R120.1, U17.30 (VDD5), U18.6 (IN)
GND: C66.1, C67.1, C68.1, C73.1, C74.1, C75.1, D5.2 (A), D9.1 (K), J5.A1 (GND), J5.A12 (GND), J5.B1 (GND), J5.B12 (GND), J5.SH, Q4.2 (S), Q13.2 (S), R61.2, R114.1, R118.1, R119.1, R130.2, U17.13 (GND), U17.28 (GND), U17.31 (GND), U18.2 (GND), U19.3, U19.8, U20.3, U20.8, U21.3, U21.8
unnamed: D9.2 (A), R131.2
unnamed: Q4.3 (D), R129.2, U18.4 (EN)
unnamed: Q13.1 (G), R24.2, R60.2, R61.1
SYS_SCL: R125.1
SYS_SDA: R124.1
USB0_D_N: J5.A7 (D-), J5.B7 (D-), U21.4, U21.7
USB0_D_P: J5.A6 (D+), J5.B6 (D+), U21.2, U21.9
USBC1_ADDR: R113.1, R114.2, U17.22 (ADDR)
USBC1_CC1: J5.A5 (CC1), U17.2 (CC1), U21.1, U21.10
USBC1_CC2: J5.B5 (CC2), U17.1 (CC2), U21.5, U21.6
USBC1_CONN_TX1_N: C70.1, J5.A2 (TX1+), U20.2, U20.9
USBC1_CONN_TX1_P: C71.1, J5.A3 (TX1-), U20.1, U20.10
USBC1_CONN_TX2_N: C69.1, J5.B2 (TX2+), U19.4, U19.7
USBC1_CONN_TX2_P: C72.1, J5.B3 (TX2-), U19.5, U19.6
USBC1_DIR: R126.1, U17.11 (DIR)
USBC1_FAULT_N: R120.2, TP27.1, U17.24 (VCONN_FAULT_N)
USBC1_FLG: R123.2, U18.3 (FLG)
USBC1_I2C_SDA: R111.2, R124.2, U17.25 (SDA/OUT1)
USBC1_ID: Q4.1 (G), R23.1, R24.1, R122.1, TP26.1, U17.27 (ID)
USBC1_INT: R110.2, U17.23 (INT_N/OUT3)
USBC1_ISC_SCL: R112.2, R125.2, U17.26 (SCL/OUT2)
USBC1_ISET: R130.1, U18.5 (ISET)
USBC1_I_MODE: R116.2, U17.3 (CURRENT_MODE)
USBC1_PEN: R121.2, R122.2, R129.1
USBC1_PORT: R115.1, U17.4 (PORT)
USBC1_RX1_N: J5.B10 (RX1-), U17.14 (RX1-), U20.5, U20.6
USBC1_RX1_P: J5.B11 (RX1+), U17.15 (RX1+), U20.4, U20.7
USBC1_RX2_N: J5.A10 (RX2-), U17.18 (RX2-), U19.1, U19.10
USBC1_RX2_P: J5.A11 (RX2+), U17.19 (RX2+), U19.2, U19.9
USBC1_TX1_N: C70.2, U17.16 (TX1-)
USBC1_TX1_P: C71.2, U17.17 (TX1+)
USBC1_TX2_N: C69.2, U17.20 (TX2-)
USBC1_TX2_P: C72.2, U17.21 (TX2+)
USBC1_VBUS: C74.2, C75.2, D5.1 (K), J5.A4 (VBUS), J5.A9 (VBUS), J5.B4 (VBUS), J5.B9 (VBUS), R60.1, R128.1, R131.1, U18.1 (OUT)
USBC1_VBUS_DET: R128.2, U17.5 (VBUS_DET)
USBSS1_C_RX_N: R103.2, U17.10 (RX-)
USBSS1_C_RX_P: R107.2, U17.9 (RX+)
USBSS1_C_TX_N: R108.2, U17.7 (TX-)
USBSS1_C_TX_P: R109.2, U17.6 (TX+)
USBSS2_RX_N: R103.1
USBSS2_RX_P: R107.1
USBSS2_TX_N: R108.1
USBSS2_TX_P: R109.1
USB_FLASH_ID: Q13.3 (D), R23.2
~USBC1_EN_CC: R119.2, U17.29 (ENn_CC)
~USBC1_EN_MUX: R118.2, U17.12 (ENn_MUX)
~USBC1_INT: R110.1

Notes on the sheet:
Mode HIGH - DFP (HOST ONLY) LOW - UFP (DEVICE ONLY) DNP - DRP (DUAL ROLE PORT)
Enable MUX
Both DNP - GPIO Mode HIGH - I2C Mode 0x67 LOW - I2C Mode 0x47
USB-C 1
10k - 3A 500k - 1.5A DNP - 900mA
LOW: DFP role HIGH: NO ATTACH/UFP
NOTE: Populate 1/3
USBC1
LOW: VCONN OC TRIP HIGH: NORMAL OPERATION
Enable CC controller
