cmu-argus-1/Avionics-JetsonCarrier/usb.kicad_sch

## KiCad design usb.kicad_sch (2024-07-27)

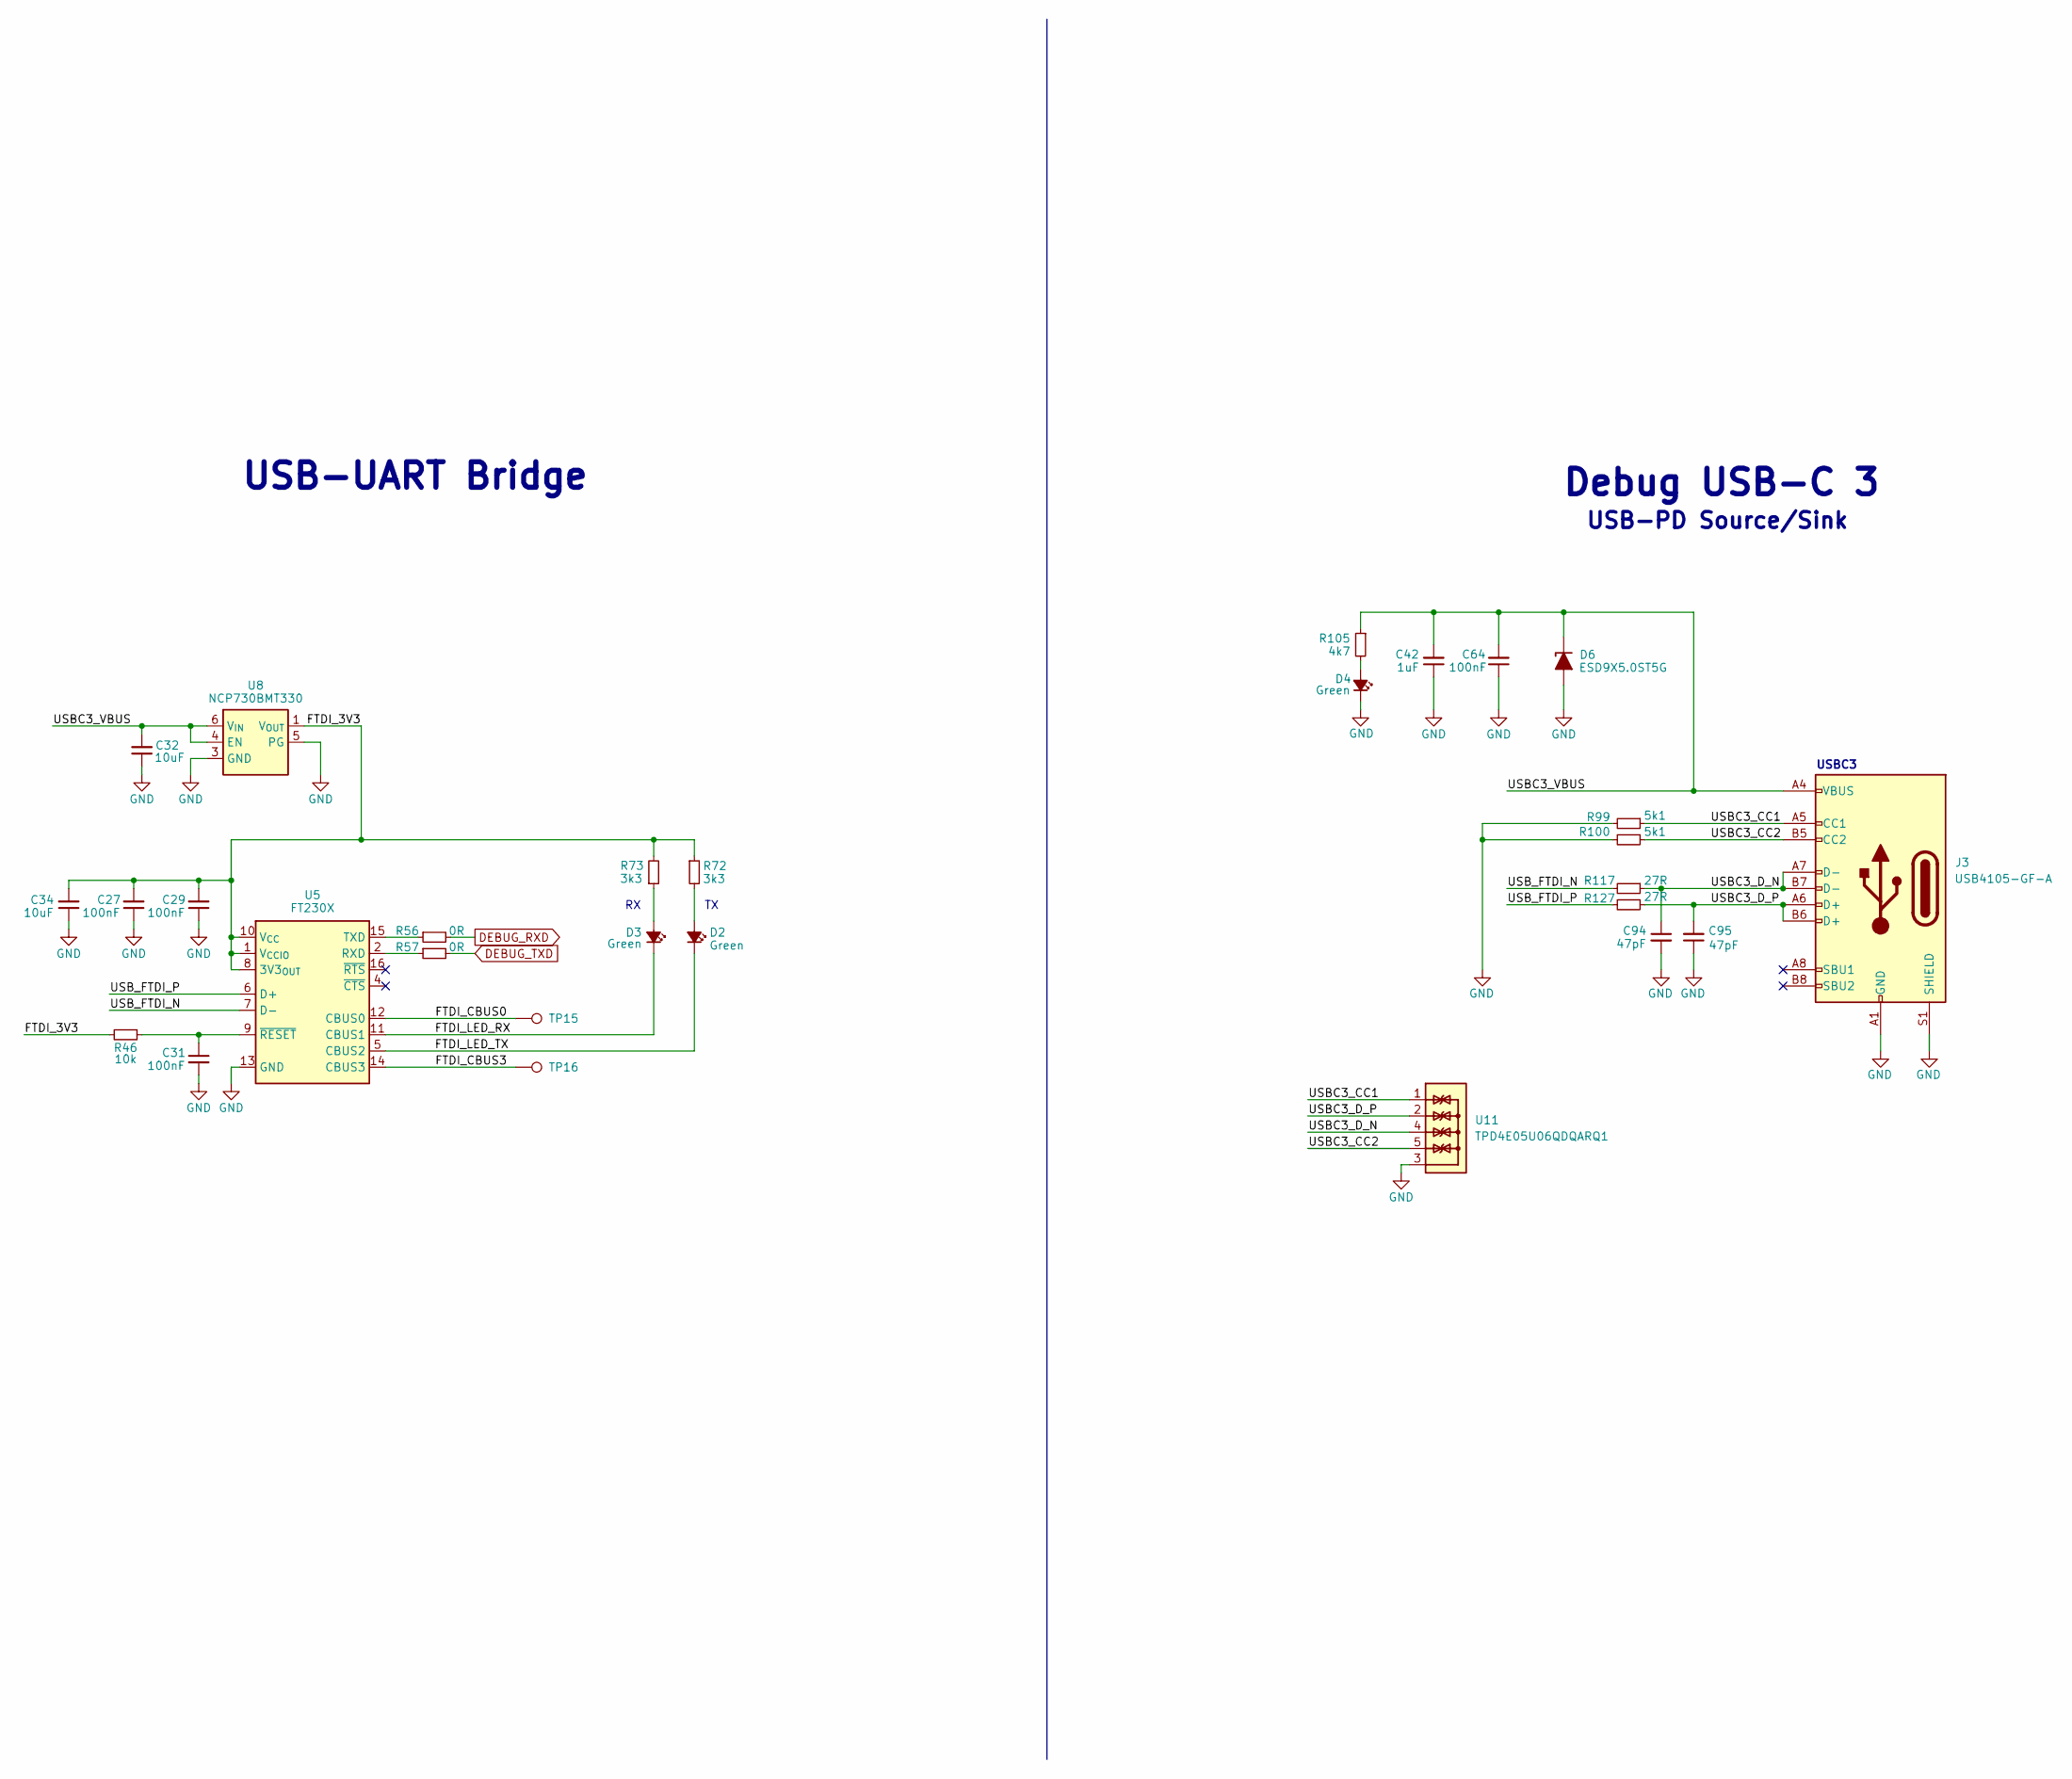
[picture p10: schematic usb.kicad_sch]

Parts:
C27, C29, C31, C64: 100nF; C_0603_1608Metric; Voltage 50V; MPN GRM155R61H104KE14D
C32: 10uF; C_0603_1608Metric; MPN C1608X5R1E106M080AC
C34: 10uF; C_0603_1608Metric; MPN CC0402MRX5R5BB106
C42: 1uF; C_0603_1608Metric; MPN C0402C105M4PACTU
C94, C95: 47pF; C_0402_1005Metric; MPN C0402C470J5GACTU
D2, D3, D4: LED_G_0603_LTST-C190GKT; LED_0603_1608Metric; MPN LTST-C190GKT
D6: ESD9X5.0ST5G; D_SOD-923; MPN DF2S30FS
J3: USB4105-GF-A; USB_C_Receptacle_GCT_USB4105-xx-A_16P_TopMnt_Horizontal; MPN USB4105-GF-A
R46: 10k; R_0603_1608Metric; Tolerance 1%; MPN CR0402-FX-1002GLF
R56, R57: 0R; R_0402_1005Metric; MPN ERJ2GE0R00X
R72, R73: 3k3; R_0603_1608Metric; Tolerance 1%
R99, R100: 5k1; R_0402_1005Metric; Tolerance 1%
R105: 4k7; R_0603_1608Metric; Tolerance 1%; MPN CR0402-FX-4701GLF
R117, R127: 27R; R_0603_1608Metric; Tolerance 1%; MPN CR0402-FX-27R0GLF
TP15, TP16: TP_0.75mm_SMD; TP_SMD_0.75mm
U5: FT230X; QFN-16-1EP_4x4mm_P0.65mm; MPN FT230XQ-R
U8: NCP730BMT330; WSON-6-1EP_2x2mm_P0.65mm; MPN NCP730BMT330TBG
U11: TPD4E05U06QDQARQ1; USON-10_2.5x1mm_P0.5mm; MPN TPD4E05U06QDQARQ1

Connections:
DEBUG_RXD: R56.2
DEBUG_TXD: R57.2
FTDI_3V3: C27.2, C29.2, C34.2, R46.2, R72.1, R73.2, U5.1 (V_{CCIO}), U5.8 (3V3_{OUT}), U5.10 (V_{CC}), U8.1 (V_{OUT})
FTDI_CBUS0: TP15.1, U5.12 (CBUS0)
FTDI_CBUS3: TP16.1, U5.14 (CBUS3)
FTDI_LED_RX: D3.1 (K), U5.11 (CBUS1)
FTDI_LED_TX: D2.1 (K), U5.5 (CBUS2)
GND: C27.1, C29.1, C31.2, C32.1, C34.1, C42.1, C64.1, C94.2, C95.1, D4.1 (K), D6.2 (A), J3.A1 (GND), J3.A12 (GND), J3.B1 (GND), J3.B12 (GND), J3.S1 (SHIELD), R99.2, R100.2, U5.3 (GND), U5.13 (GND), U5.17 (GND), U8.3 (GND), U8.5 (PG), U8.7 (GND), U11.3, U11.8
unnamed: C31.1, R46.1, U5.9 (~RESET)
unnamed: D2.2 (A), R72.2
unnamed: D3.2 (A), R73.1
unnamed: D4.2 (A), R105.2
unnamed: R56.1, U5.15 (TXD)
unnamed: R57.1, U5.2 (RXD)
USBC3_CC1: J3.A5 (CC1), R99.1, U11.1, U11.10
USBC3_CC2: J3.B5 (CC2), R100.1, U11.5, U11.6
USBC3_D_N: C94.1, J3.A7 (D-), J3.B7 (D-), R117.1, U11.4, U11.7
USBC3_D_P: C95.2, J3.A6 (D+), J3.B6 (D+), R127.1, U11.2, U11.9
USBC3_VBUS: C32.2, C42.2, C64.2, D6.1 (K), J3.A4 (VBUS), J3.A9 (VBUS), J3.B4 (VBUS), J3.B9 (VBUS), R105.1, U8.4 (EN), U8.6 (V_{IN})
USB_FTDI_N: R117.2, U5.7 (D-)
USB_FTDI_P: R127.2, U5.6 (D+)

Notes on the sheet:
USB-UART Bridge
USB-PD Source/Sink
Debug USB-C 3
USBC3
