cmu-argus-1/Avionics-JetsonCarrier/(commit log)

2024-07-19 Schematic complete. Partial routing
    [USB3-2.kicad_sch, csi.kicad_sch, ethernet.kicad_sch, hdmi.kicad_sch, jetson-orin-baseboard.kicad_sch, m-2.kicad_sch, peripherals.kicad_sch, som.kicad_sch]
2024-07-25 Schematic Cleanup, Complete routing
    [USB3-2.kicad_sch, csi.kicad_sch, hdmi.kicad_sch, jetson-orin-baseboard.kicad_sch, m-2.kicad_sch, peripherals.kicad_sch, som.kicad_sch, supply.kicad_sch]
2024-07-26 Partial Silkscreen Cleanup
2024-07-27 Complete Silkscreen
    [m-2.kicad_sch, supply.kicad_sch, usb.kicad_sch]
