cmu-argus-1/Avionics-JetsonCarrier/(notices)

Notices in the files:
parts and their libraries:
License: Apache-2.0
License: MIT
